DucTrung1802/ROS-2-Reports/Images/Drying - evaporating solvents from painted surfaces.jpg

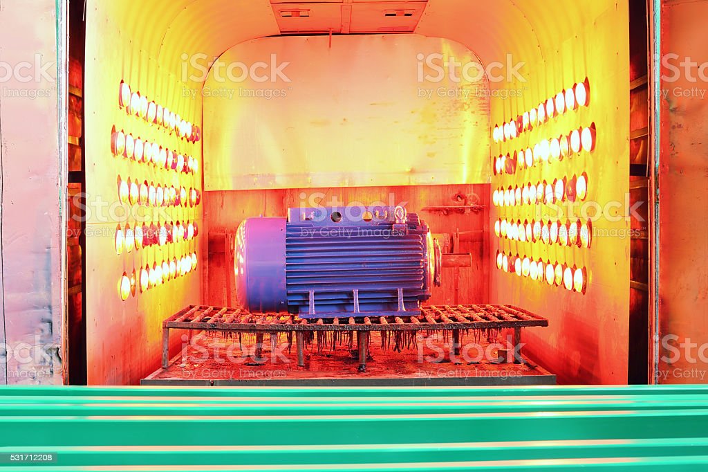
Images/Drying - evaporating solvents from painted surfaces.jpg
