DucTrung1802/ROS-2-Reports/Images/Heat treatment of metals.jpeg

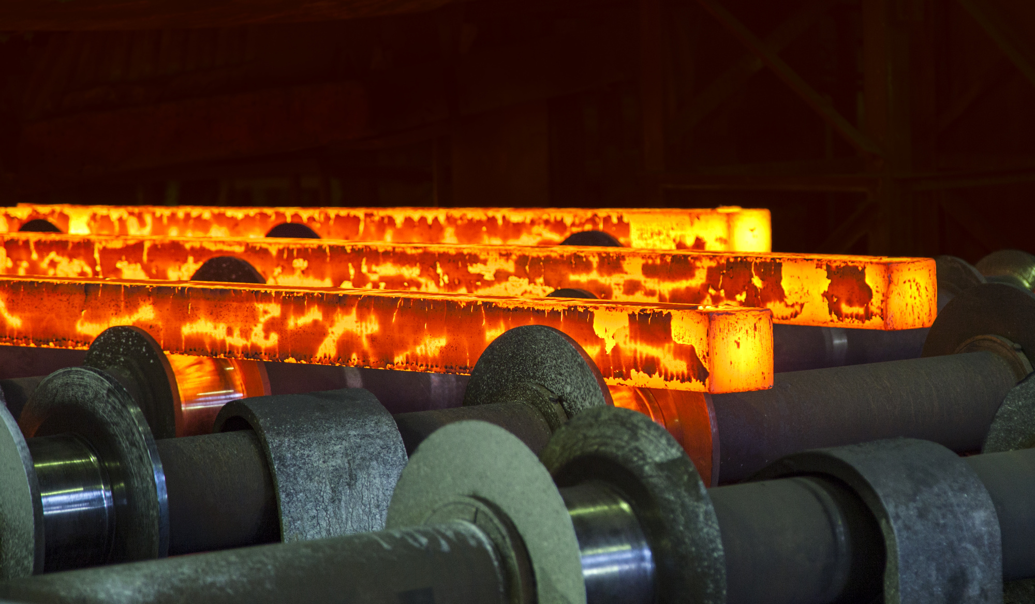
Images/Heat treatment of metals.jpeg
