DucTrung1802/ROS-2-Reports/Battery Status.docx

Battery | Mainboard | ADC | Monitor | Differience
12.58 | 12.27 | 3.072 | 3.072 | 0
12.48 | 12.20 | 3.055 | 3.044 | 0.011
12.46 | 12.19 | 3.053 | 3.039 | 0.014
12.43 | 12.13 | 3.039 | 3.022 | 0.017
12.41 | 12.14 | 3.042 | 3.020 | 0.022
12.36 | 12.09 | 3.03 | 3.003 | 0.027
12.31 | 12.04 | 3.016 | 2.979 | 0.037
12.30 | 12.00 | 3.003 | 2.96 | 0.043
12.24 | 11.96 | 2.997 | 2.945 | 0.052
12.19 | 11.91 | 2.983 | 2.924 | 0.059
12.18 | 11.91 | 2.983 | 2.923 | 0.060
12.13 | 11.86 | 2.97 | 2.902 | 0.068
12.12 | 11.82 | 2.961 | 2.89 | 0.071
12.10 | 11.80 | 2.956 | 2.879 | 0.077
12.08 | 11.78 | 2.951 | 2.872 | 0.079
12.05 | 11.75 | 2.944 | 2.858 | 0.086

calibration
