DucTrung1802/ROS-2-Reports/Mục lục ServingBot - Lý Đức Trung.docx

HA NOI UNIVERSITY OF SCIENCE AND TECHNOLOGY

BACHELOR THESIS PROJECT

Serving Mobile Robot Design

LY DUC TRUNG

trung.ld181930@sis.hust.edu.vn

Mentor: | Ph. D Le Minh Thuy
Department: | Instrumentation and industrial informatics
School: | Electrical Engineering

HA NOI, 01/2022

TABLE OF CONTENTS

TABLE OF CONTENTS

LIST OF FIGURES

LIST OF TABLES

# CHAPTER 1. GENERAL INTRODUCTION ABOUT MOBILE ROBOT

## 1.1 Overall information about mobile robot

## 1.2 Serving mobile robot design planning

# CHAPTER 2. GENERAL HARDWARE DESIGN FOR SERVING MOBILE ROBOT

## 2.1 Hardware components

### 2.1.1 Raspberry Pi 4

### 2.1.2 ESP32 microcontroller

### 2.1.3 Motors

### 2.1.4 Motor driver

### 2.1.5 Encoders

### 2.1.6 Ultrasonic sensors

### 2.1.7 Lidar

### 2.1.8 Inertial measurement unit

### 2.1.9 OLED display

### 2.1.10 Infrared sensor

### 2.1.11 Voltage sensor

## 2.2 Hardware structure design

# CHAPTER 3. ROS 2 FRAMEWORK FOR DEVELOPING ROBOTS

## 3.1 Robot software platforms

## 3.2 The basis for selecting ROS 2

## 3.3 The change of the ROS version

## 3.4 ROS 2 introduction

# CHAPTER 4. FIRMWARE DESIGN FOR SERVING MOBILE ROBOT

## 4.1 Raspberry Pi 4 configuration

### 4.1.1 Ubuntu version

### 4.1.2 zRAM

### 4.1.3 ROS 2 Galactic

### 4.1.4 Multiple I2C buses

## 4.2 Serving mobile robot firmware architecture

## 4.3 Firmware for motor driver block

### 4.3.1 Firmware for ESP32 microcontroller

## 4.4 Firmware for ultrasonic sensors

## 4.5 Firmware for lidar

## 4.6 Firmware for inertial measurement unit

## 4.7 Firmware for OLED display

## 4.8 Firmware for infrared sensor

## 4.9 Firmware for voltage sensor

# CHAPTER 5. ALGORITHM EXPLANATION FOR FIRMWARE

## 5.1 PID controller

## 5.2 Fuzzy logic library

## 5.3 Kinematic Model for calculating Odometry data

## 5.4 Kalman filter

## 5.5 Median filter

# CHAPTER 6. OPTIMIZATION

## 6.1 Object oriented programming

## 6.2 Multithreading programming

# CHAPTER 7. EXPERIMENT AND RESULTS

## 7.1 Comparison of PID controller and Fuzzy PID controller

## 7.2 Obstacle avoidance using an array of ultrasonic sensors test cases

## 7.3 Restaurant serving test cases

## 7.4 Serving mobile robot design result

CONCLUSION AND FUTURE DEVELOPMENT

REFERENCES
