DucTrung1802/ROS-2-Reports/Images/121 Remote IO error.png

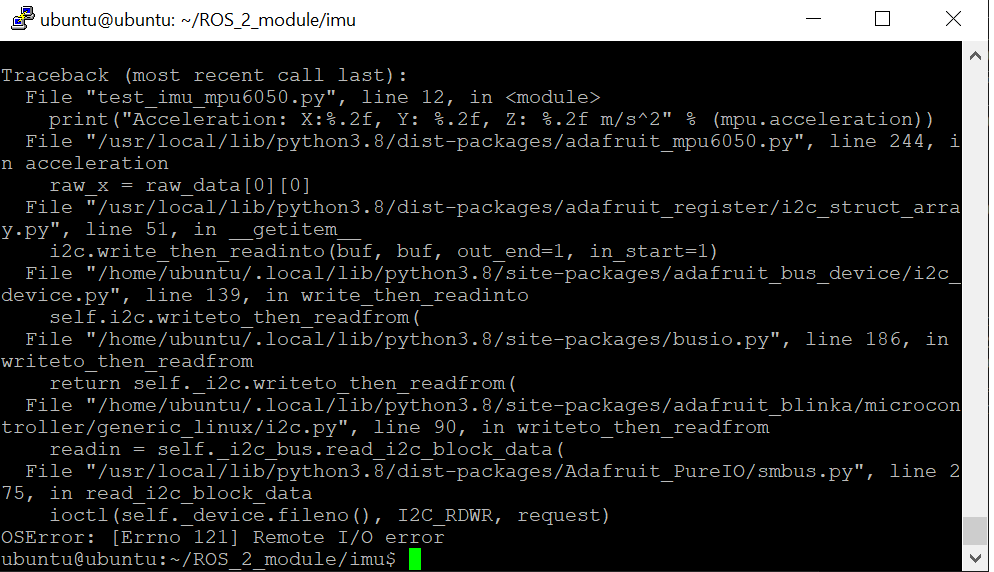
Images/121 Remote IO error.png
