DucTrung1802/ROS-2-Reports/Images/A sample camera message.png

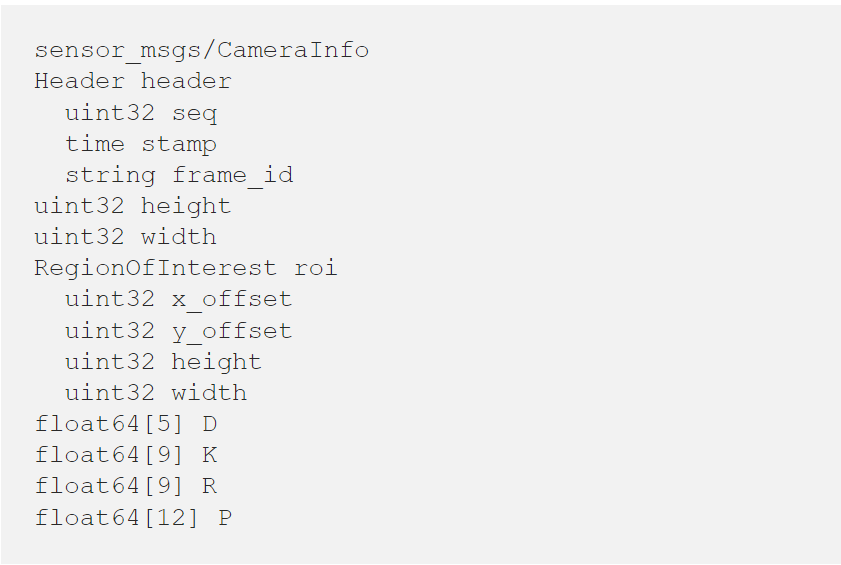
Images/A sample camera message.png
