DucTrung1802/ROS-2-Reports/Images/addRule method of Mamdani Fuzzy System class.png

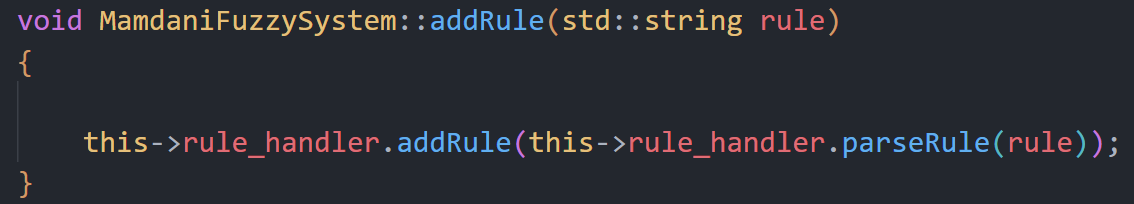
Images/addRule method of Mamdani Fuzzy System class.png
