DucTrung1802/ROS-2-Reports/Images/anti-windup flowchart.png

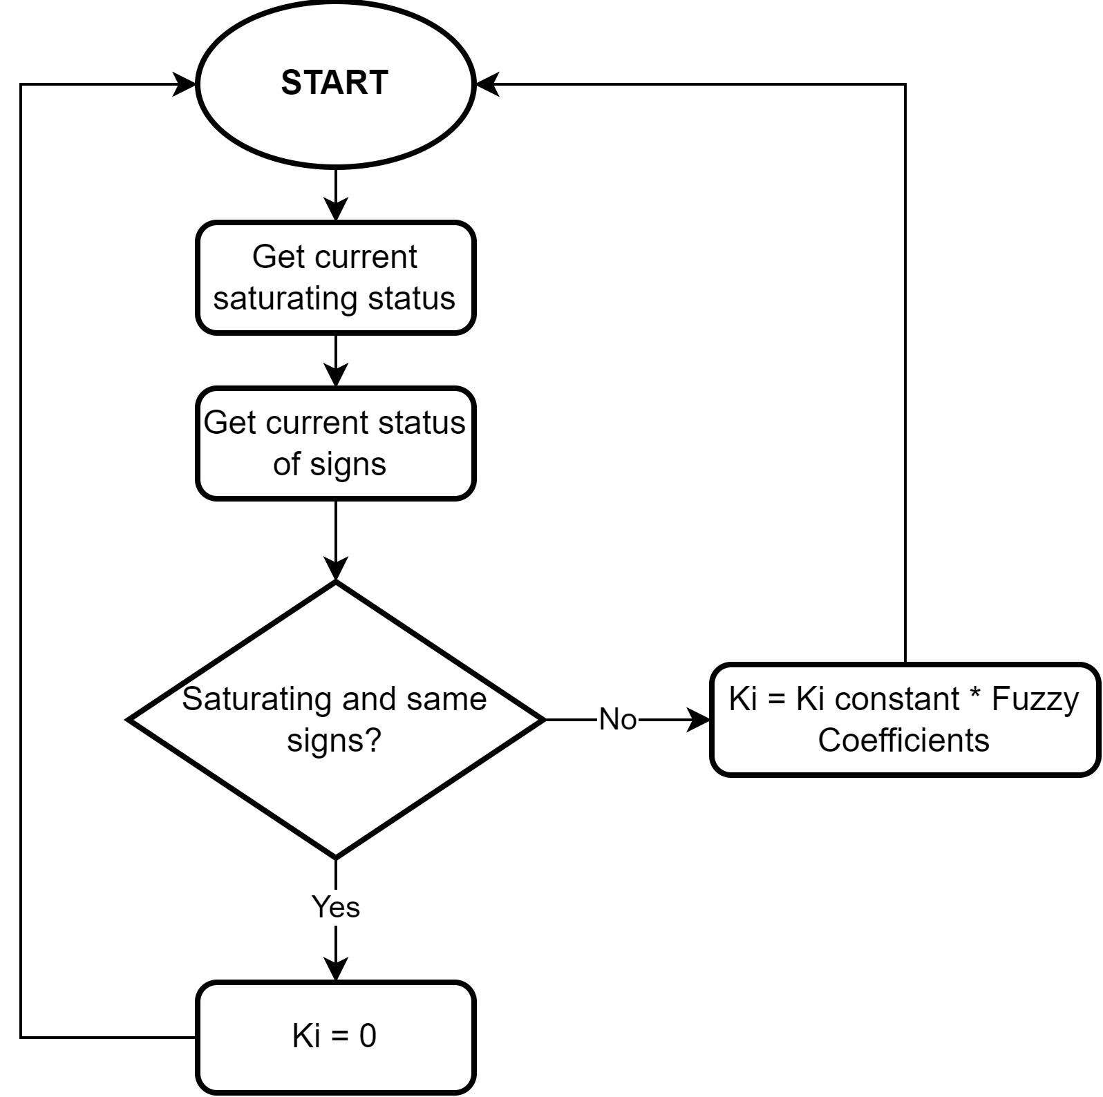
Images/anti-windup flowchart.png
