DucTrung1802/ROS-2-Reports/Images/Baking.jpg

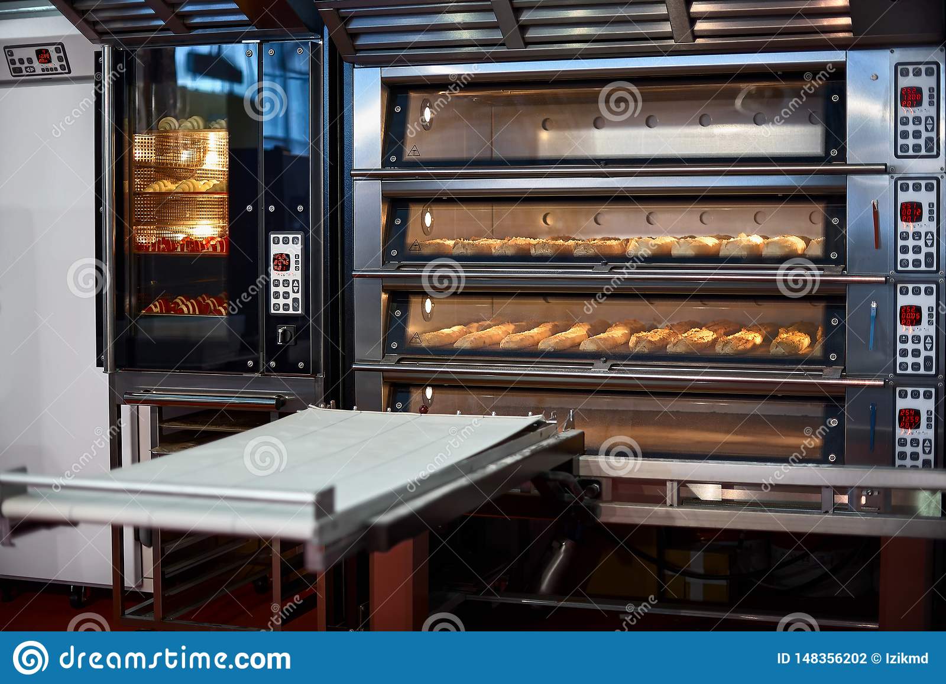
Images/Baking.jpg
