DucTrung1802/ROS-2-Reports/Images/Baking.webp

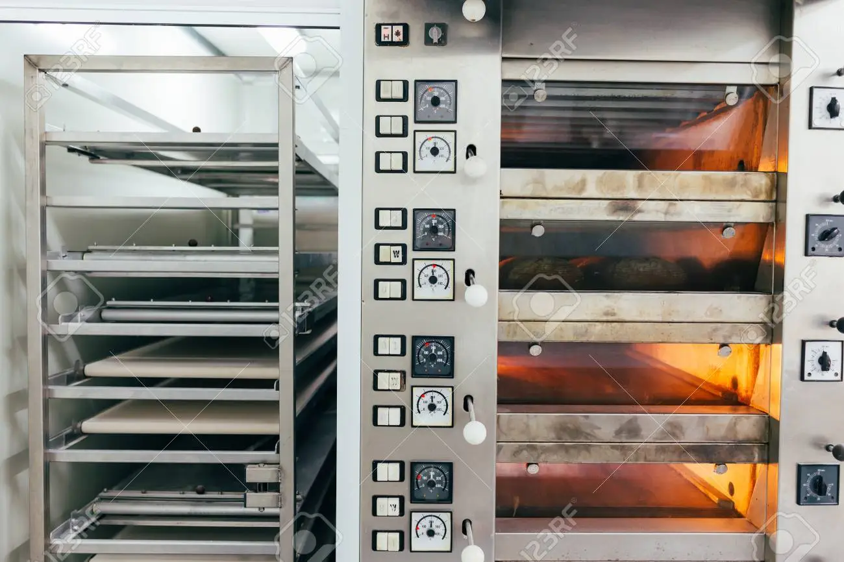
Images/Baking.webp
