DucTrung1802/ROS-2-Reports/Images/Binary AND vs Fuzzy AND.png

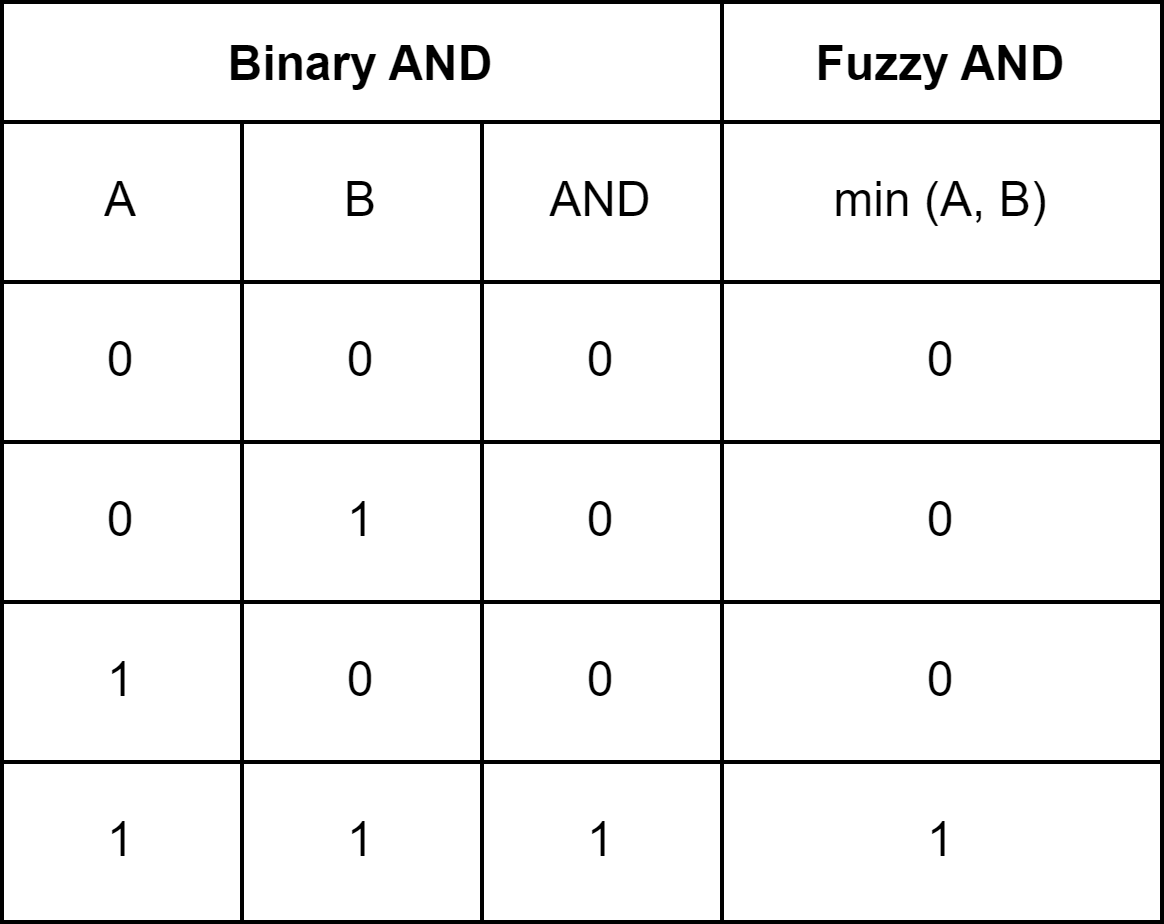
Images/Binary AND vs Fuzzy AND.png
