DucTrung1802/ROS-2-Reports/Images/C++ files compilation.png

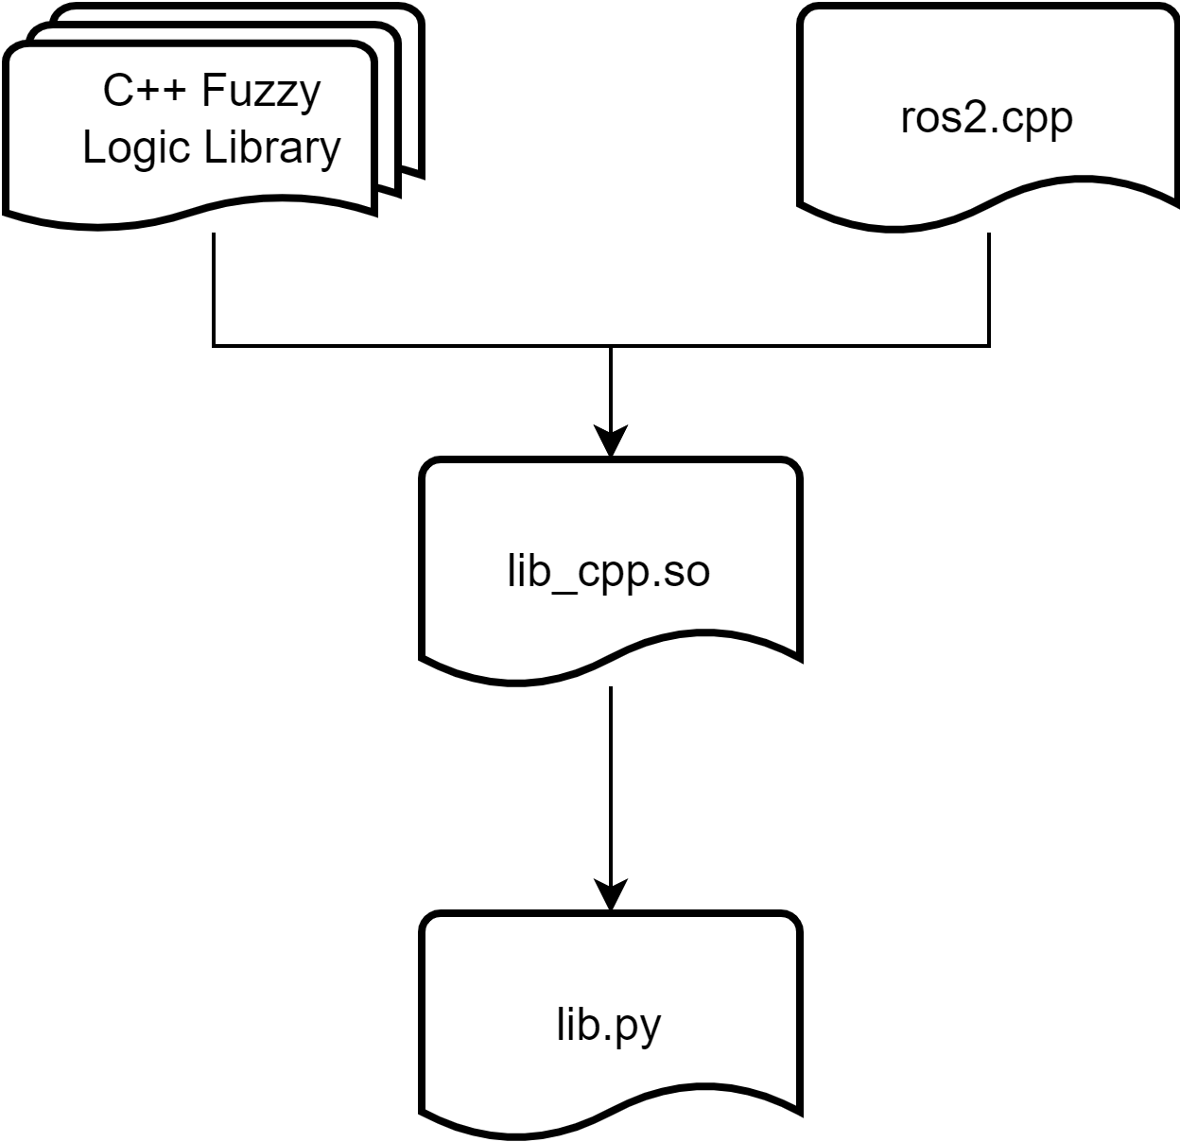
Images/C++ files compilation.png
