DucTrung1802/ROS-2-Reports/Images/C++ Fuzzy Logic Library.png

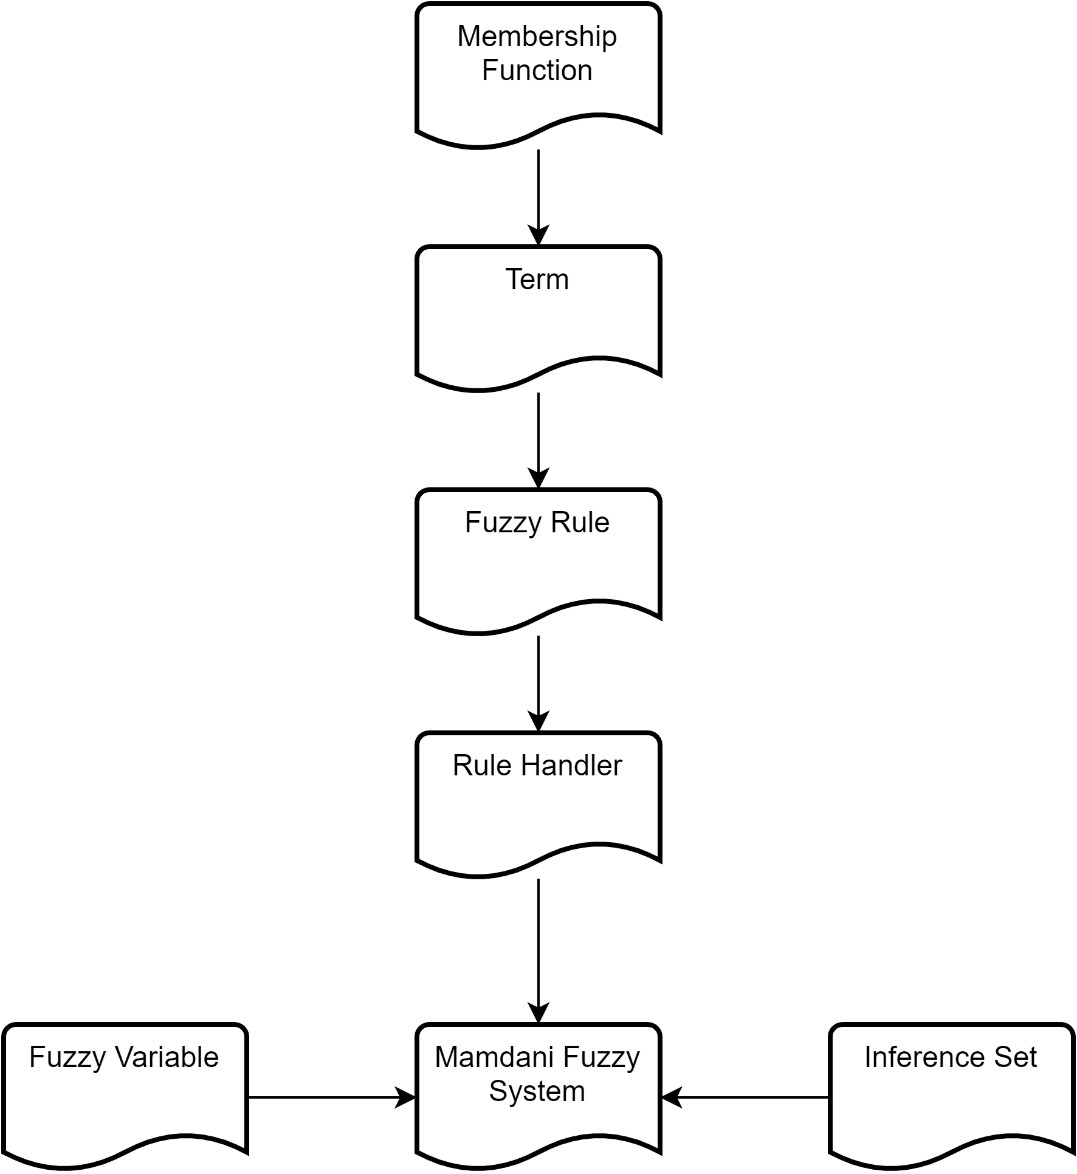
Images/C++ Fuzzy Logic Library.png
