DucTrung1802/ROS-2-Reports/Images/calculate method of Mamdani Fuzzy System.png

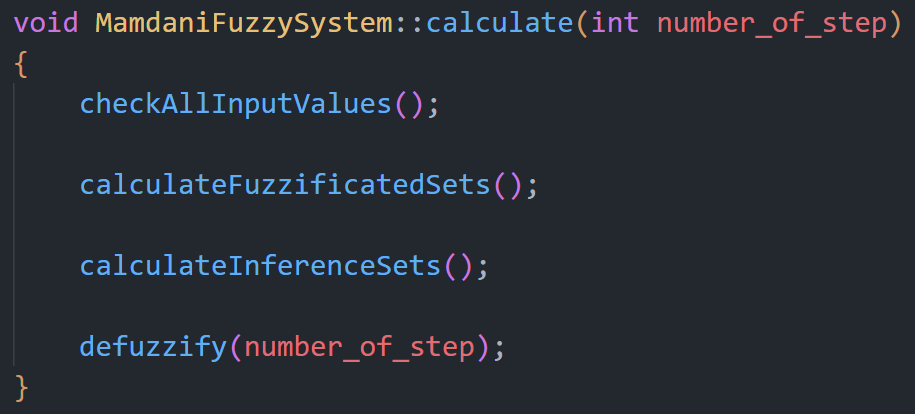
Images/calculate method of Mamdani Fuzzy System.png
