DucTrung1802/ROS-2-Reports/Images/Calling C++ code from Python.png

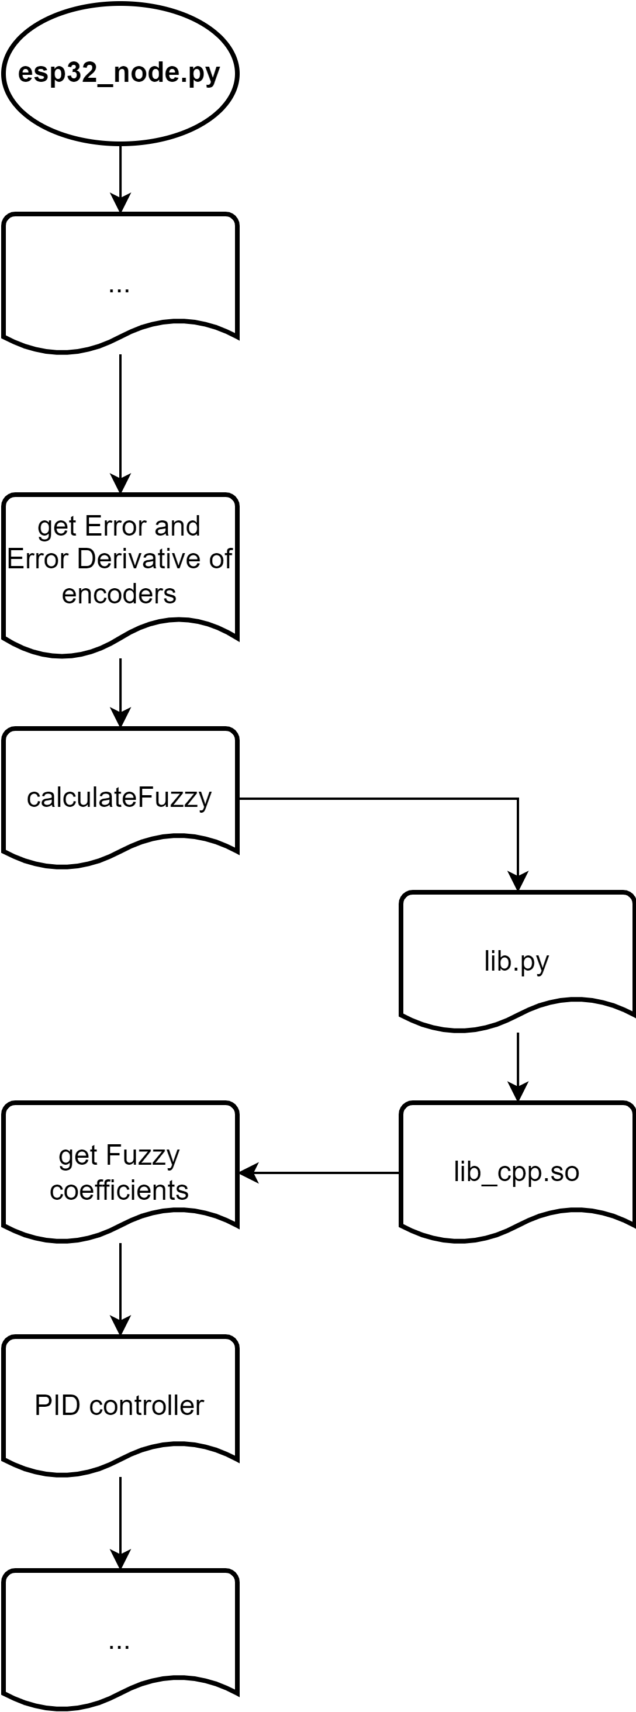
Images/Calling C++ code from Python.png
