DucTrung1802/ROS-2-Reports/Images/Centroid of combined shape.png

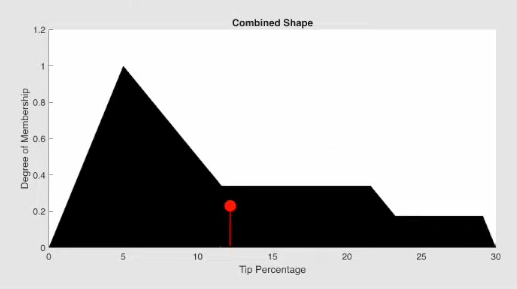
Images/Centroid of combined shape.png
