DucTrung1802/ROS-2-Reports/Images/Combined Shape of Inference Set.png

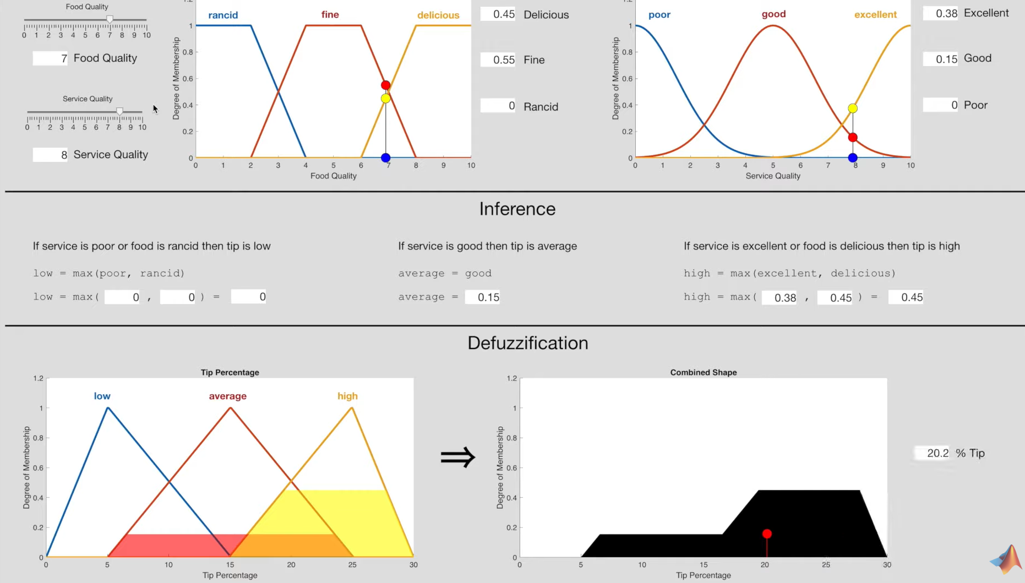
Images/Combined Shape of Inference Set.png
