DucTrung1802/ROS-2-Reports/Images/Composition of the RViz screen.png

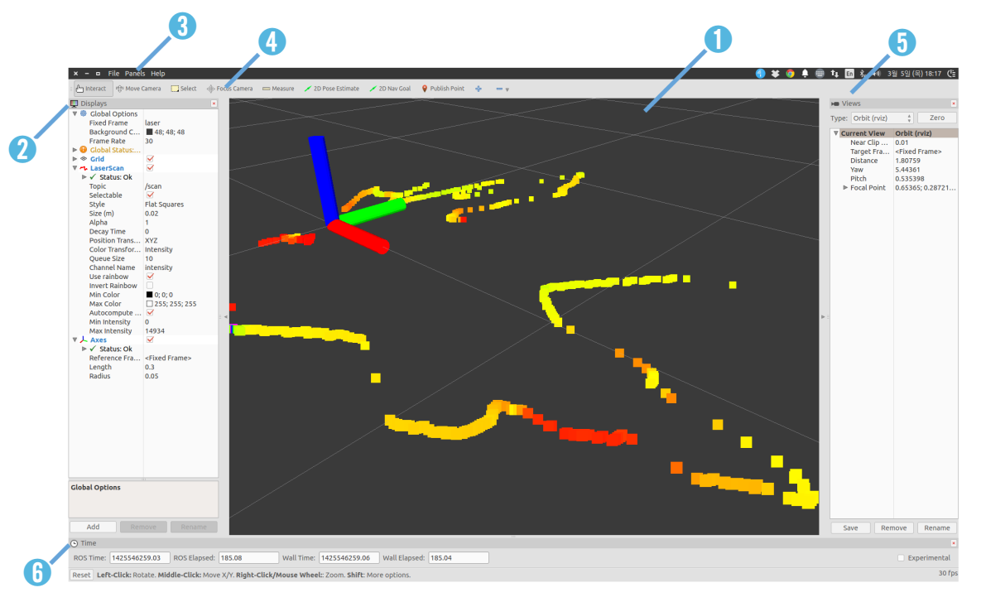
Images/Composition of the RViz screen.png
