DucTrung1802/ROS-2-Reports/Images/Curing rubber.jpg

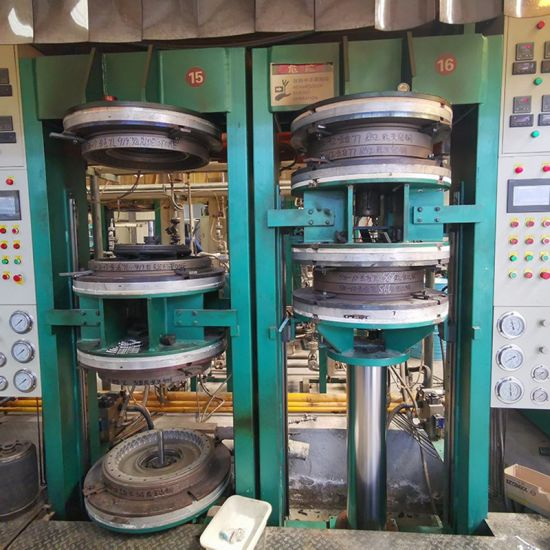
Images/Curing rubber.jpg
