DucTrung1802/ROS-2-Reports/Images/dtoverlay in bashrc.png

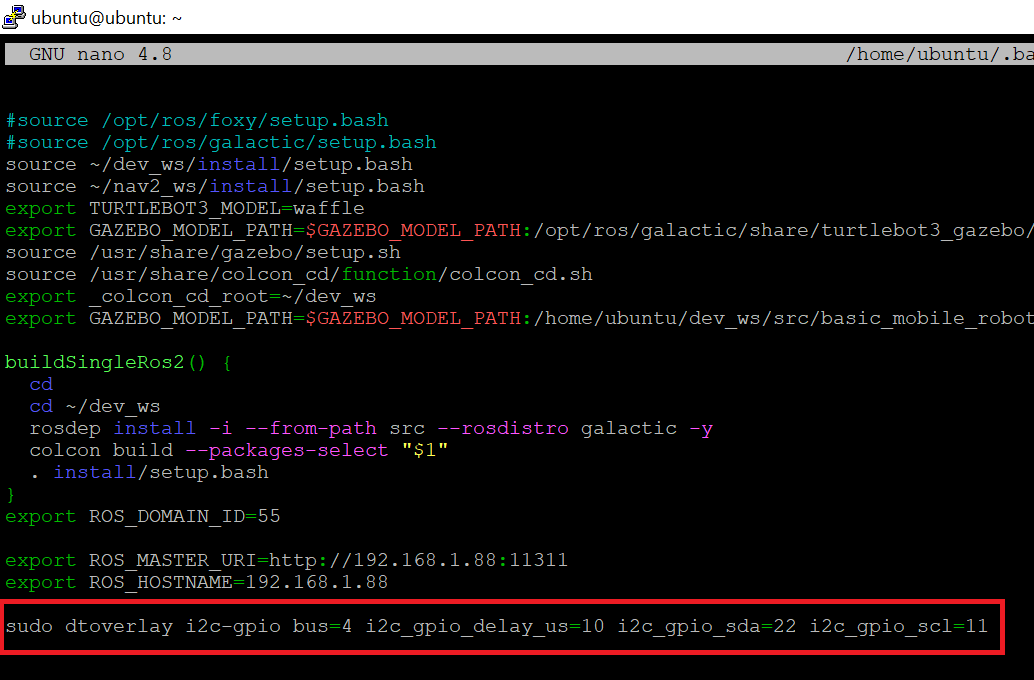
Images/dtoverlay in bashrc.png
