DucTrung1802/ROS-2-Reports/Images/Example of Fuzzificated Set.png

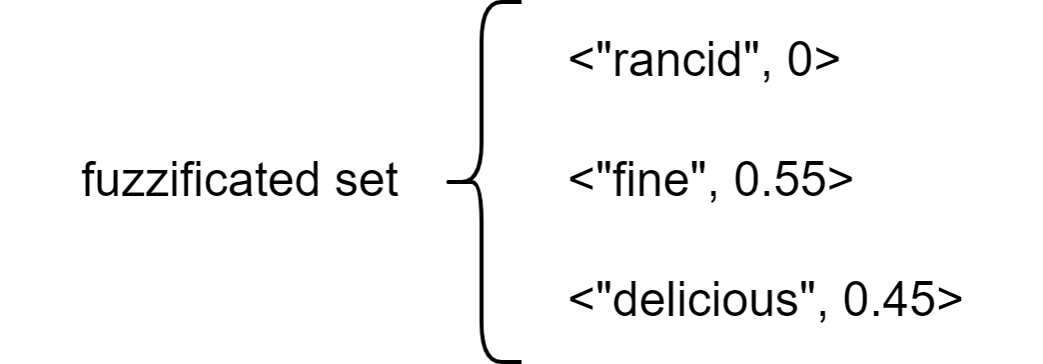
Images/Example of Fuzzificated Set.png
