DucTrung1802/ROS-2-Reports/Images/Example of Inference Set.png

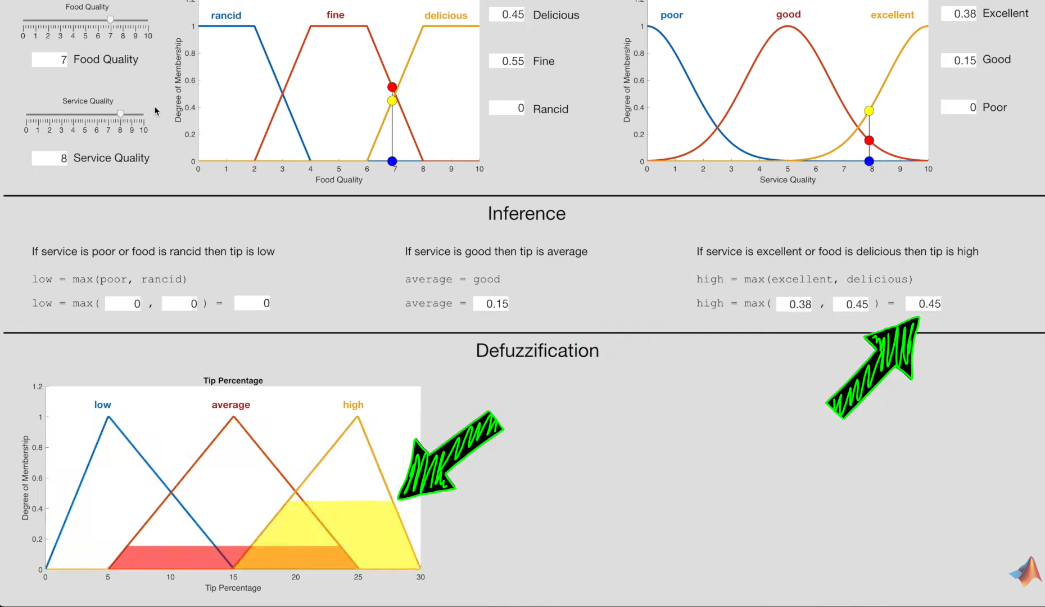
Images/Example of Inference Set.png
