DucTrung1802/ROS-2-Reports/Images/Example of list_of_term.png

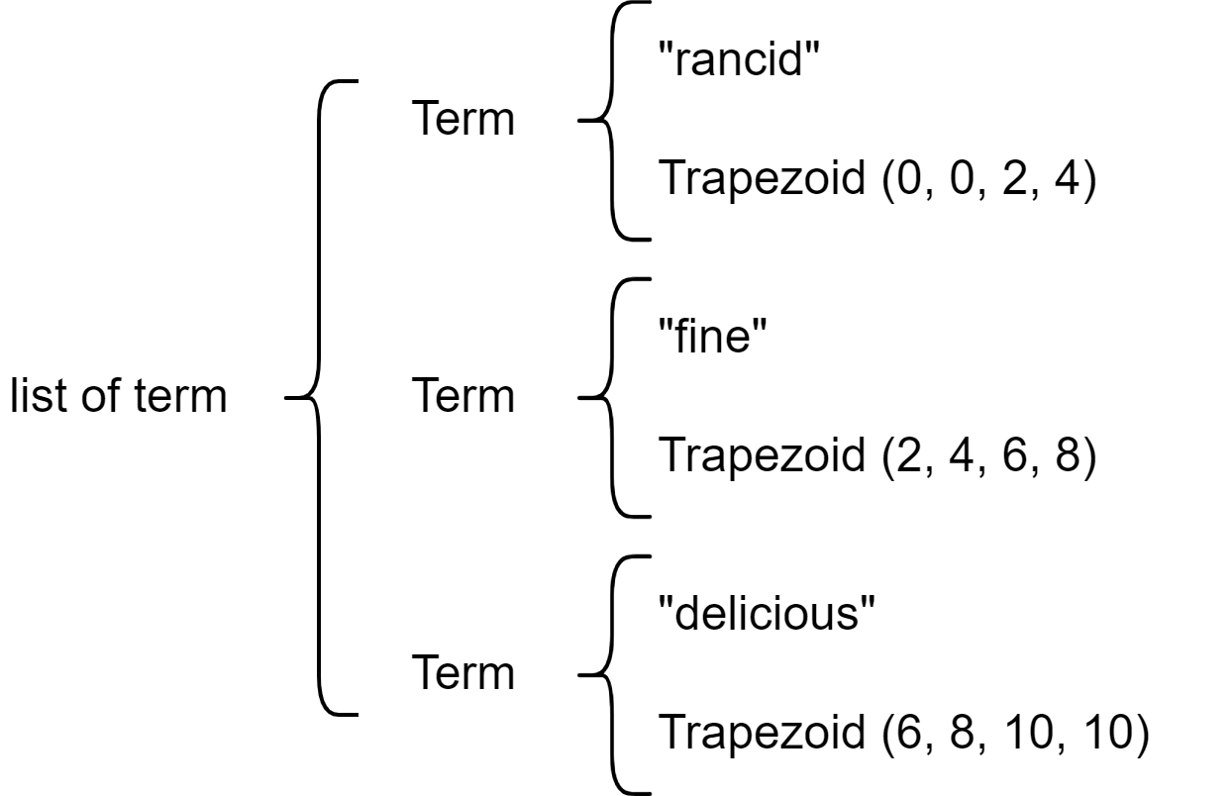
Images/Example of list_of_term.png
