DucTrung1802/ROS-2-Reports/Images/filter bandwith of IMU MPU-6050.png

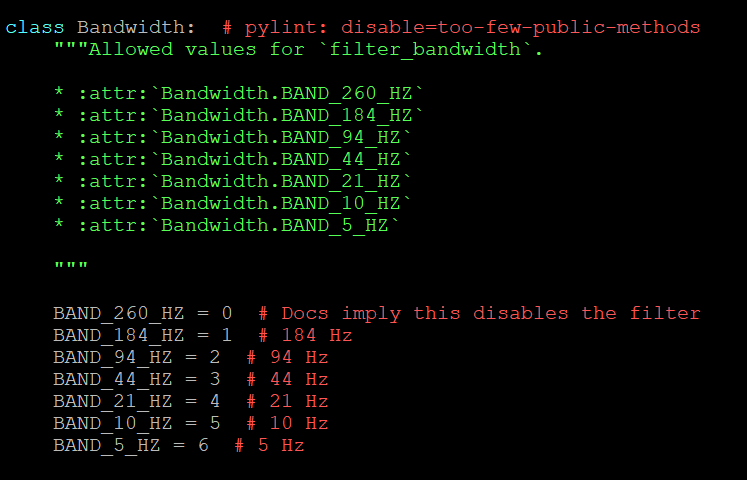
Images/filter bandwith of IMU MPU-6050.png
