DucTrung1802/ROS-2-Reports/Images/Flowchart of Raspberry Pi 4 for infrared sensor node.png

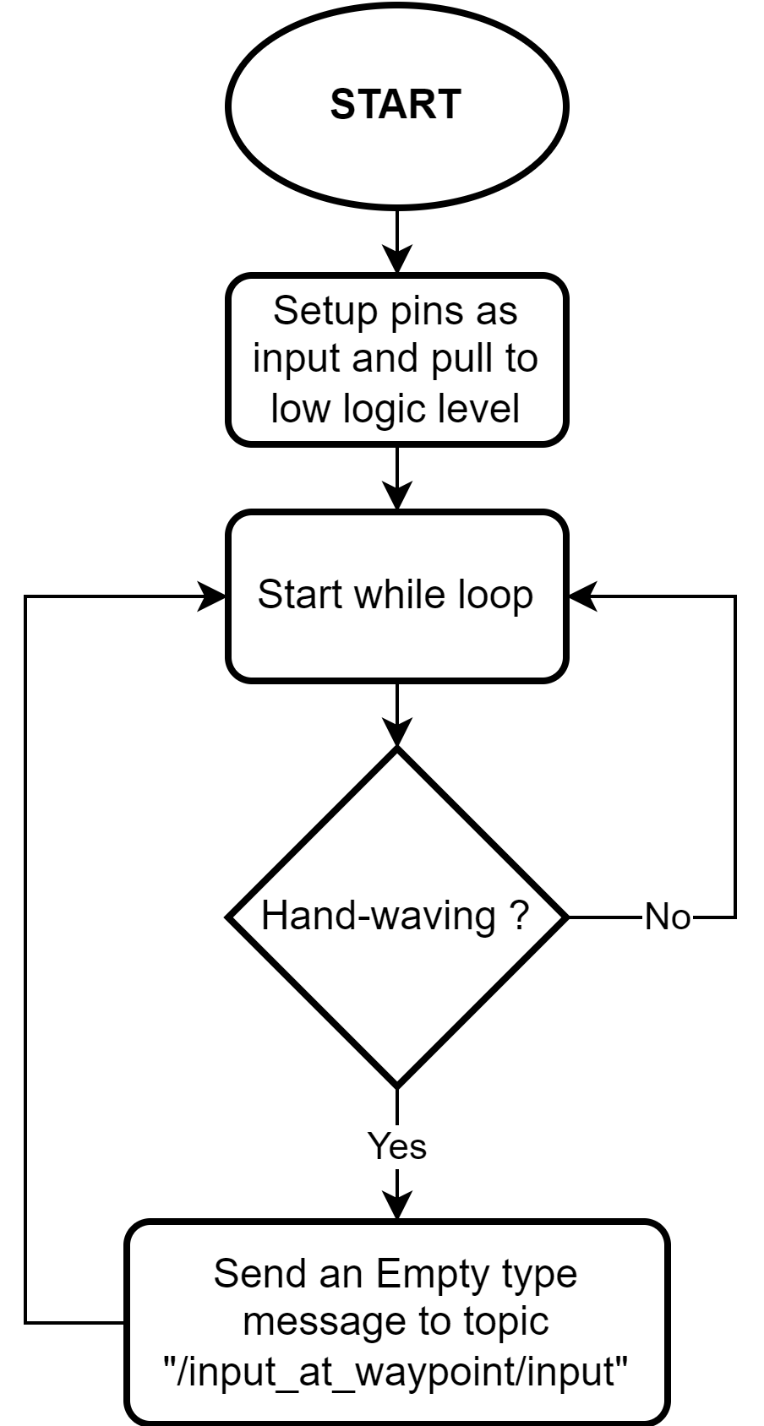
Images/Flowchart of Raspberry Pi 4 for infrared sensor node.png
