DucTrung1802/ROS-2-Reports/Images/Fuzzy PID controller flowchart.png

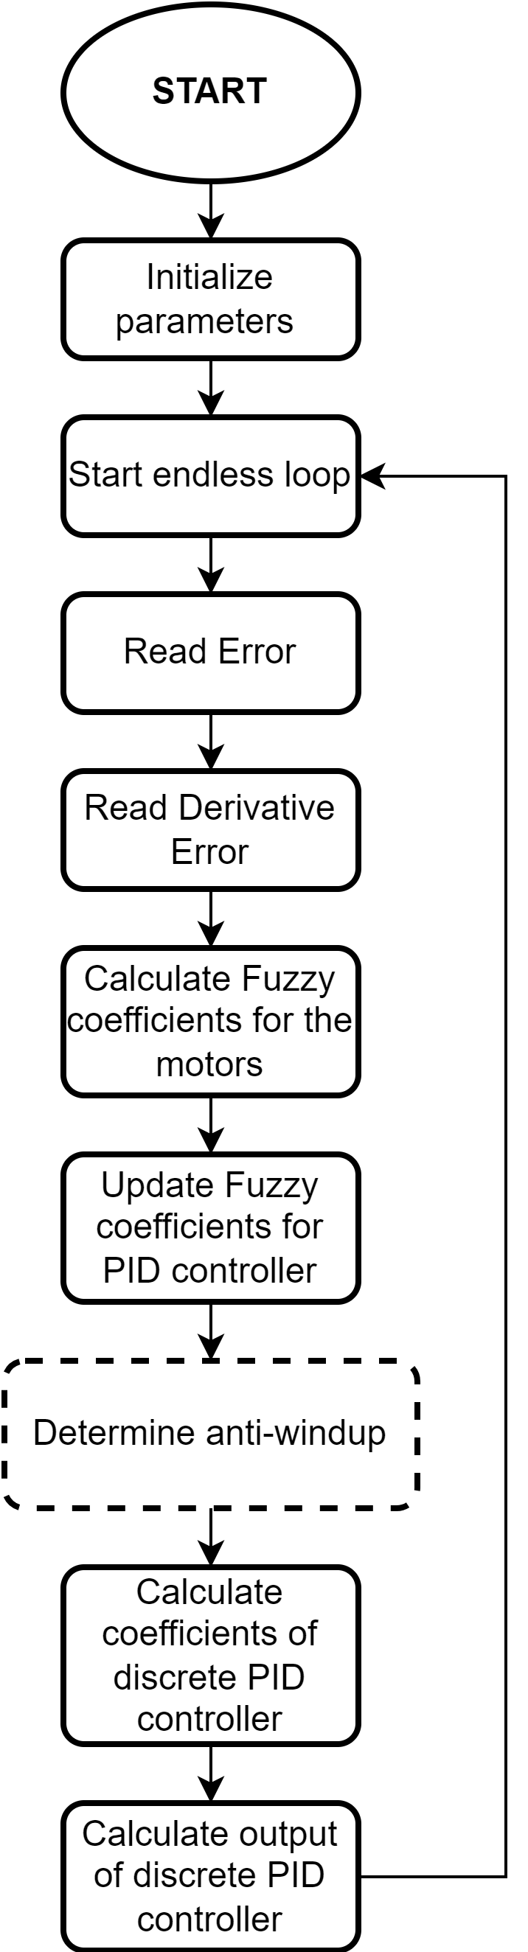
Images/Fuzzy PID controller flowchart.png
