DucTrung1802/ROS-2-Reports/Images/Fuzzy Rule class.png

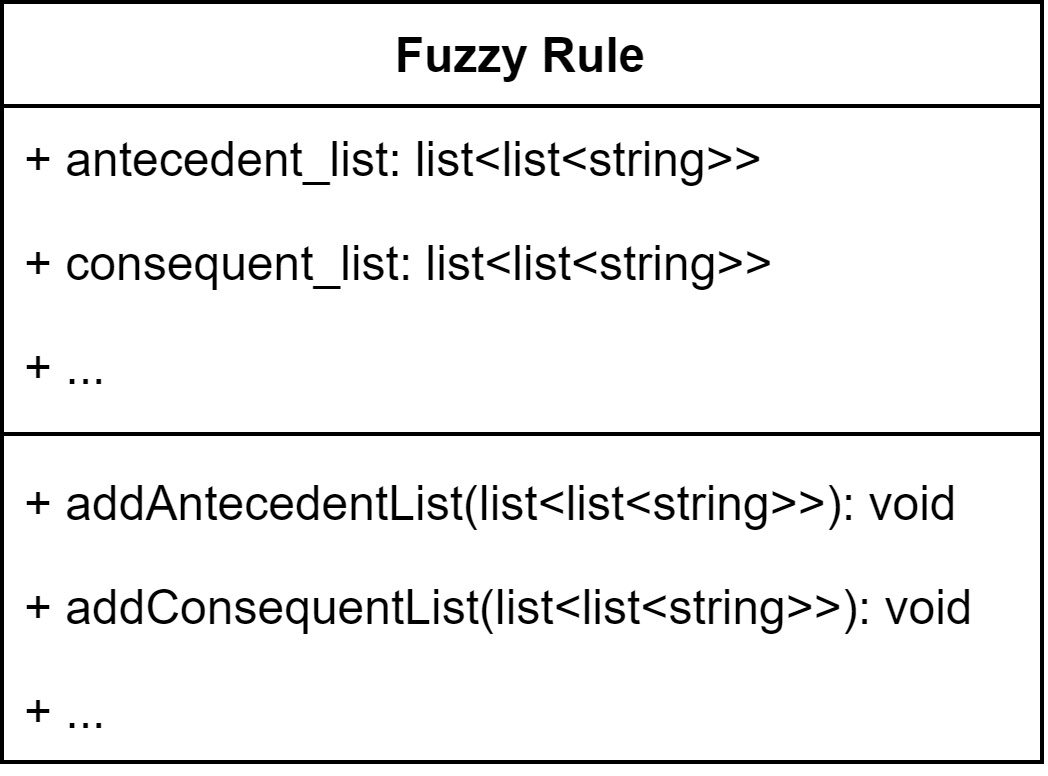
Images/Fuzzy Rule class.png
