DucTrung1802/ROS-2-Reports/Images/Fuzzy Rule Example.png

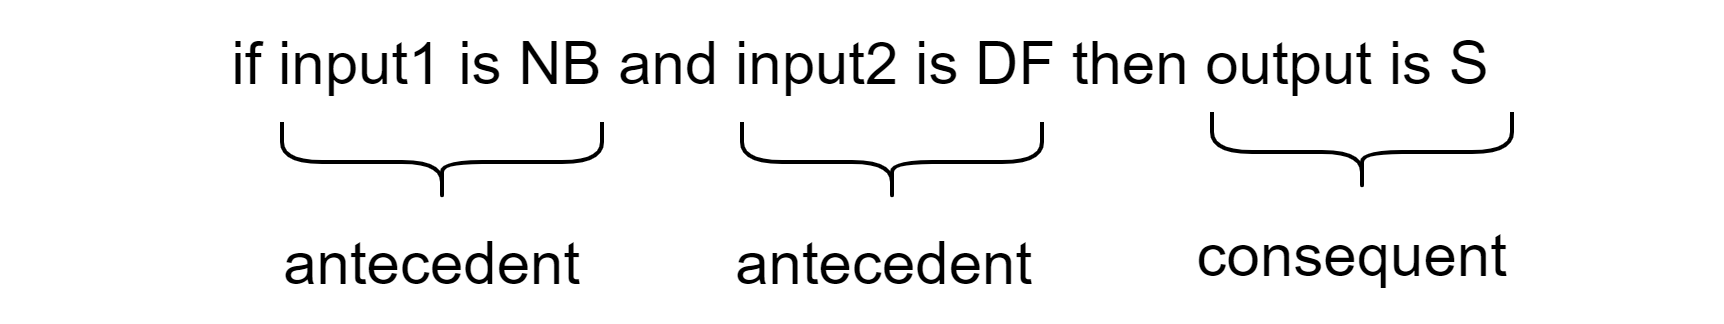
Images/Fuzzy Rule Example.png
