DucTrung1802/ROS-2-Reports/Images/Fuzzy Variable class.png

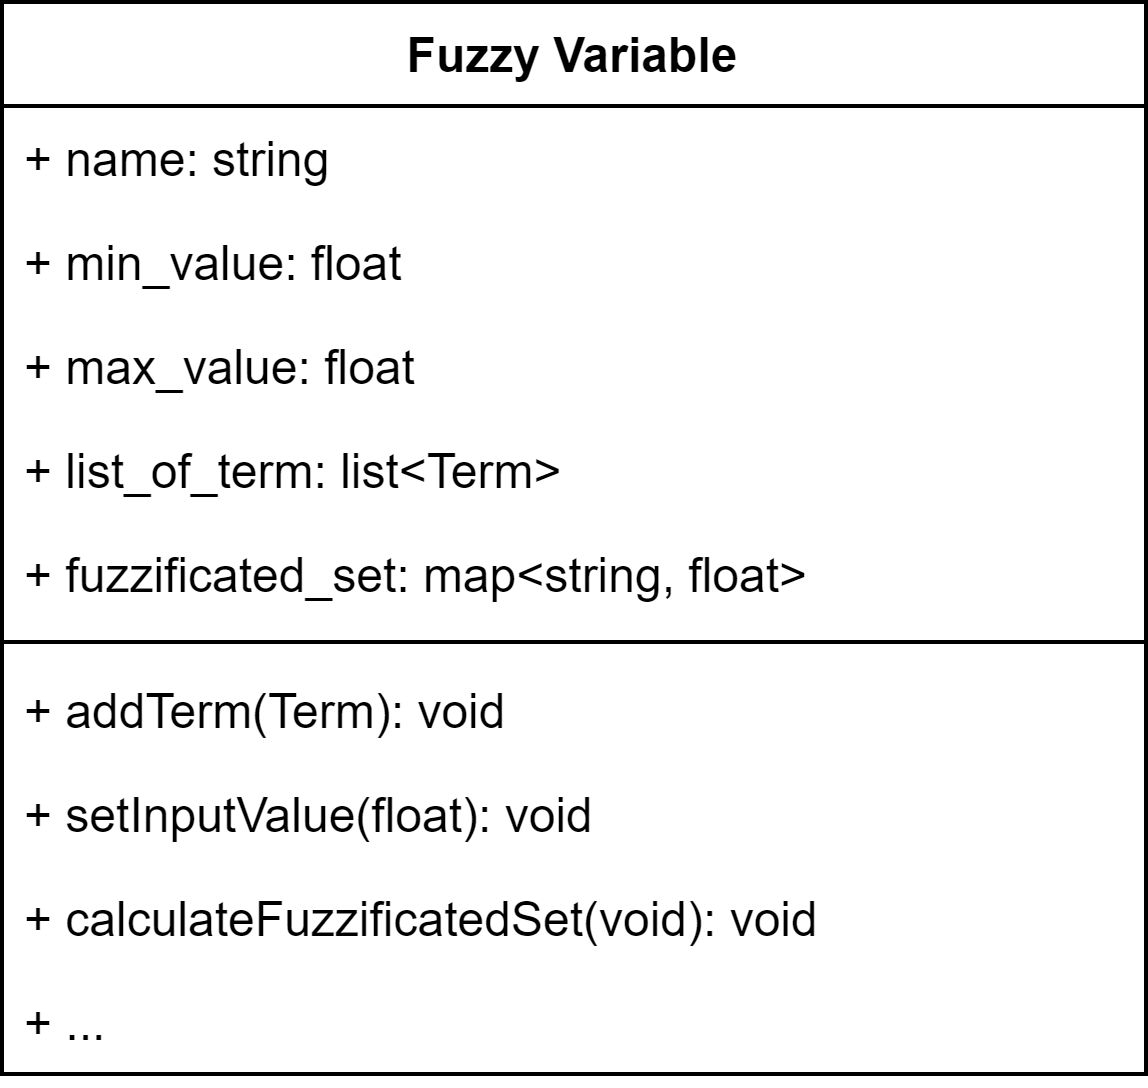
Images/Fuzzy Variable class.png
