DucTrung1802/ROS-2-Reports/Images/IMU runs normally.png

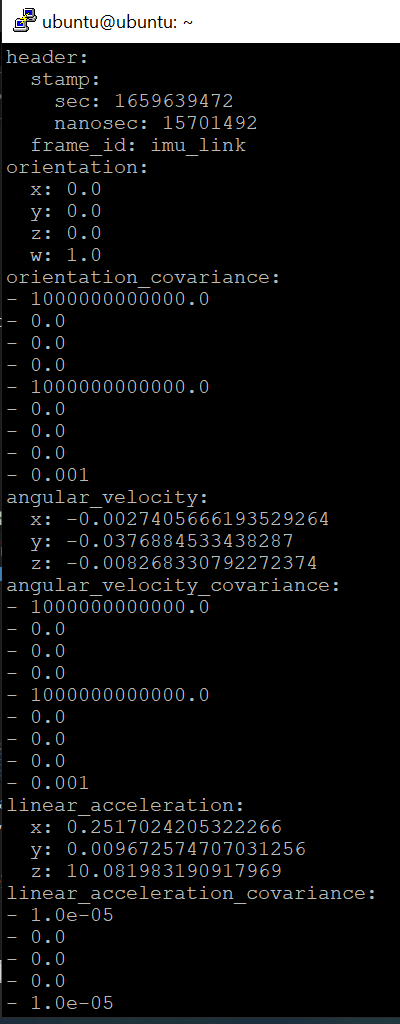
Images/IMU runs normally.png
