DucTrung1802/ROS-2-Reports/Images/Inference Set class.png

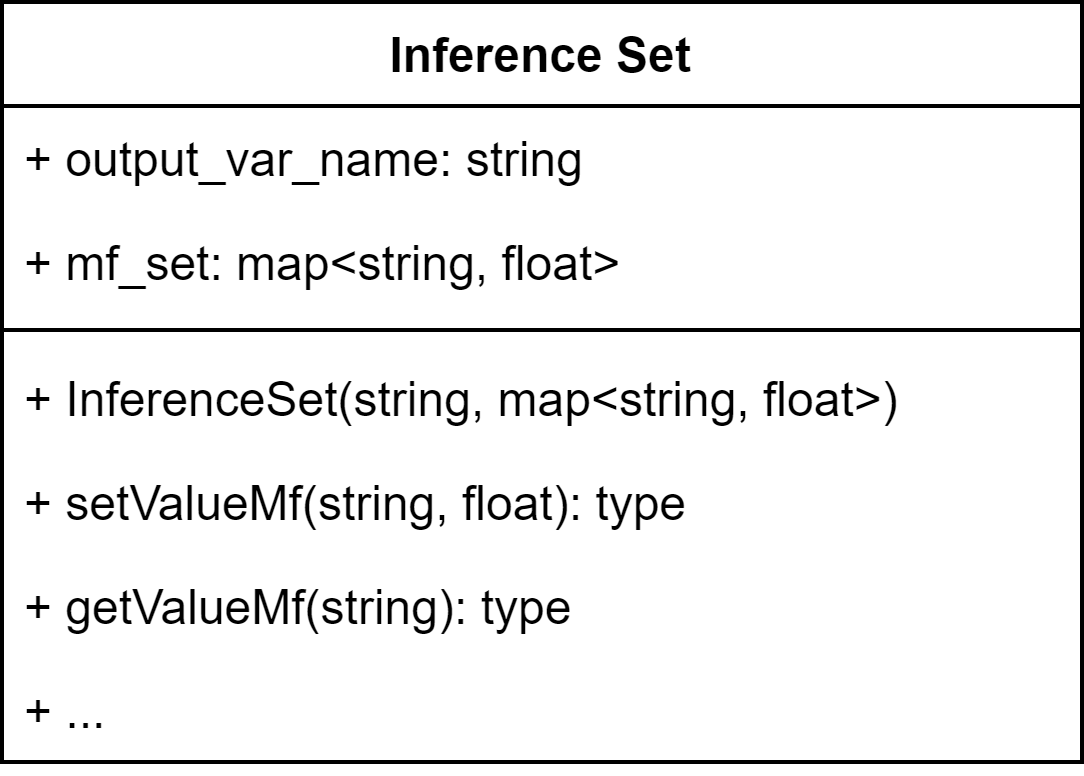
Images/Inference Set class.png
