DucTrung1802/ROS-2-Reports/Images/Infrared sensor block.png

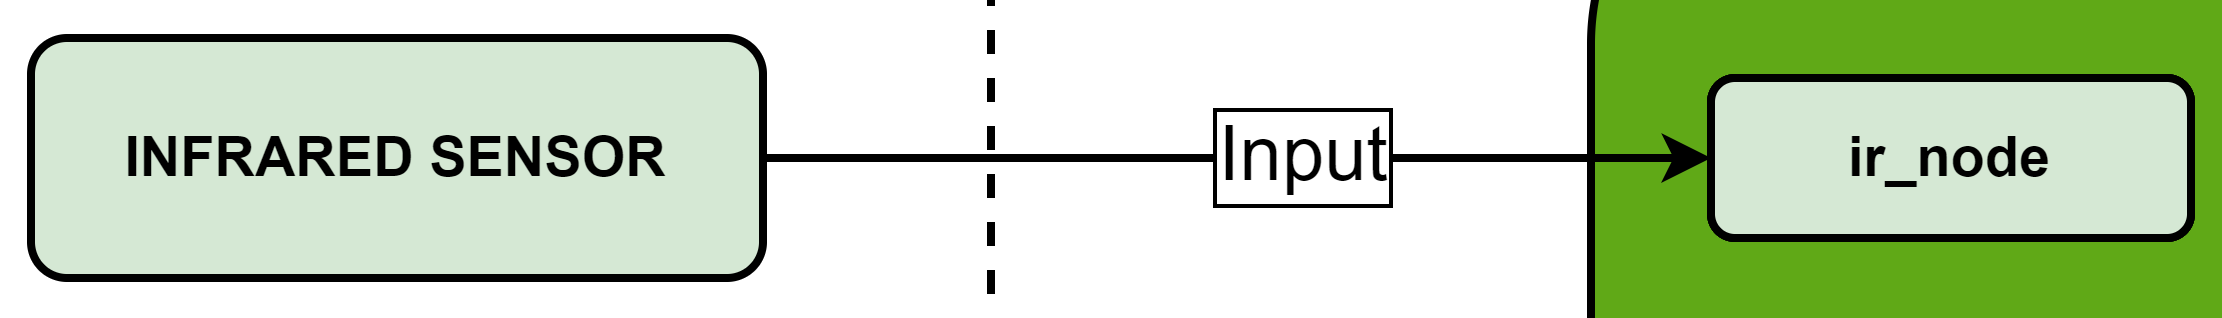
Images/Infrared sensor block.png
