DucTrung1802/ROS-2-Reports/Images/Initializing input variables of Fuzzy system.png

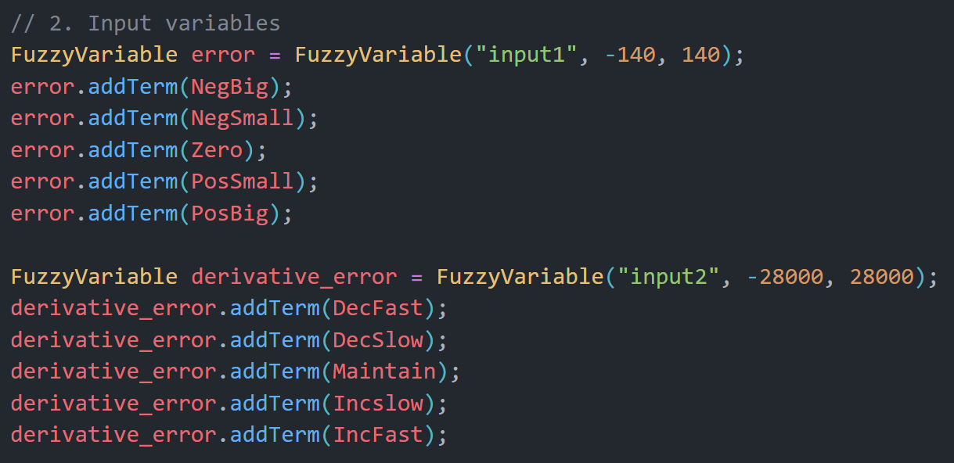
Images/Initializing input variables of Fuzzy system.png
