DucTrung1802/ROS-2-Reports/Images/Initializing output variables of Fuzzy system.png

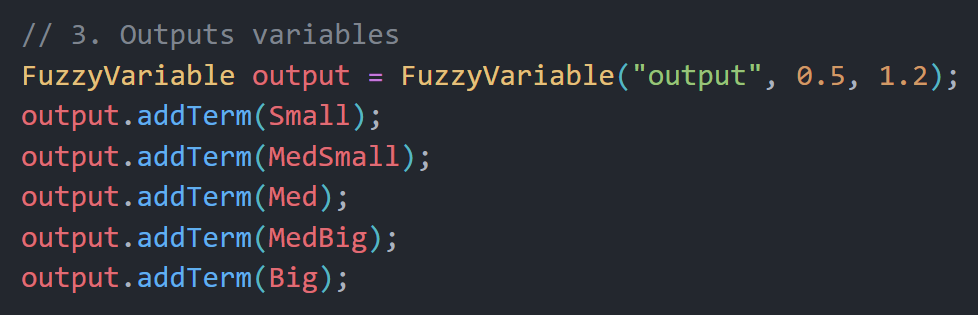
Images/Initializing output variables of Fuzzy system.png
