DucTrung1802/ROS-2-Reports/Images/Initializing rules of Fuzzy system.png

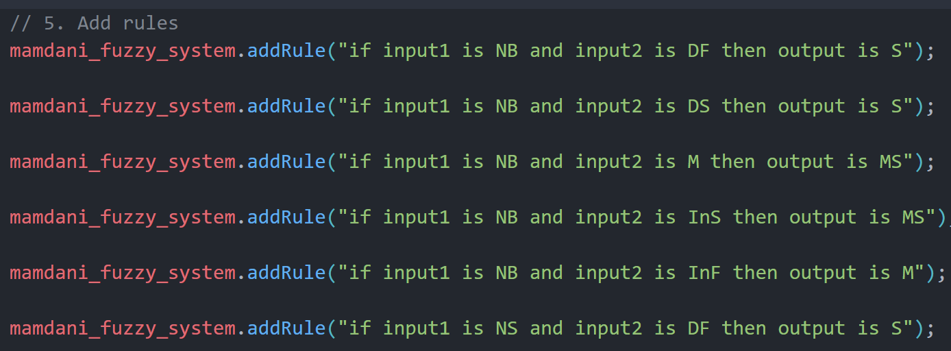
Images/Initializing rules of Fuzzy system.png
