DucTrung1802/ROS-2-Reports/Images/Initializing terms for derivative error of Fuzzy system.png

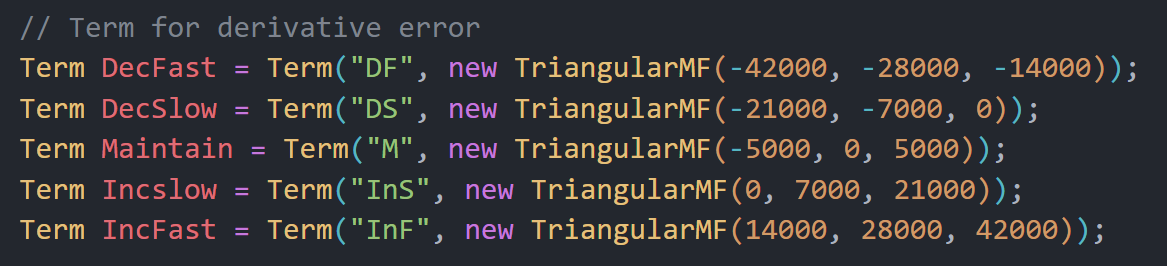
Images/Initializing terms for derivative error of Fuzzy system.png
