DucTrung1802/ROS-2-Reports/Images/Integral vs Sum.png

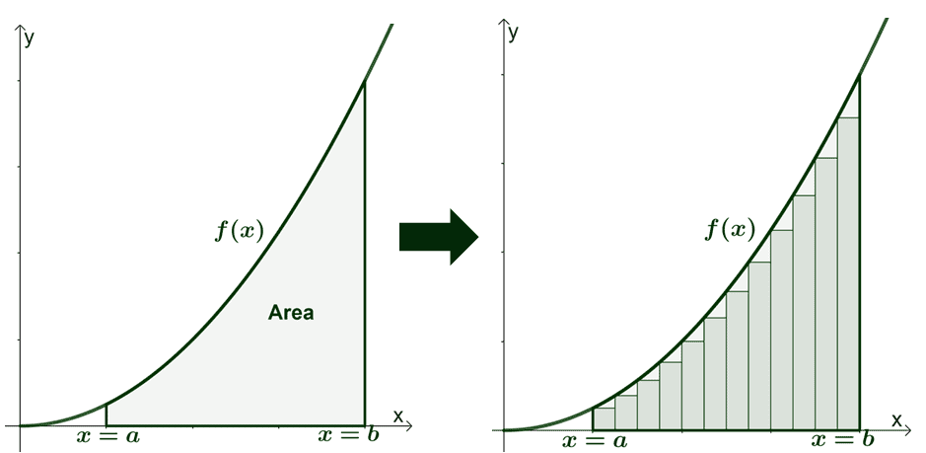
Images/Integral vs Sum.png
