DucTrung1802/ROS-2-Reports/Images/Lidar map.png

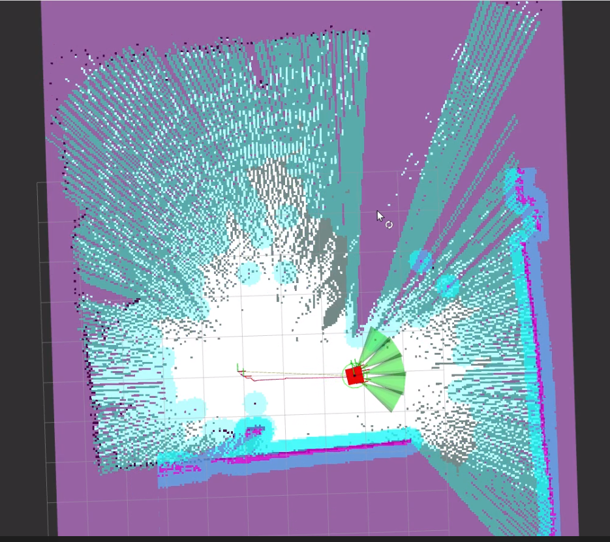
Images/Lidar map.png
