DucTrung1802/ROS-2-Reports/Images/Lidar sensor block.png

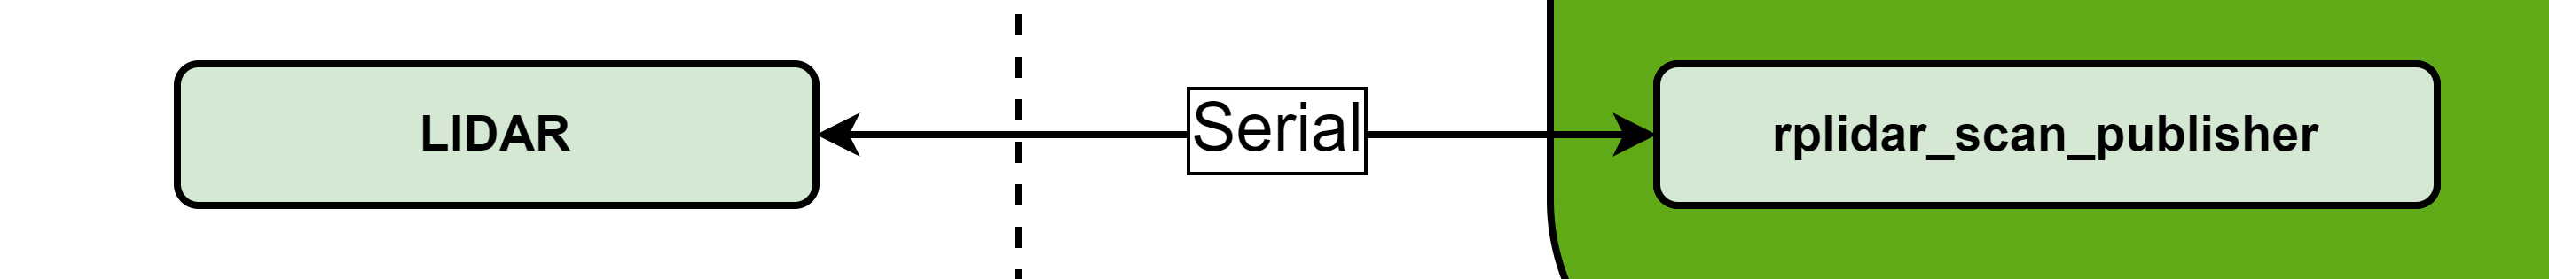
Images/Lidar sensor block.png
