DucTrung1802/ROS-2-Reports/Images/Loading screen of RViz.png

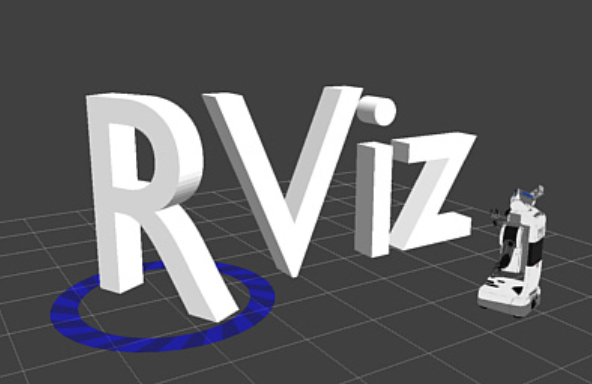
Images/Loading screen of RViz.png
