DucTrung1802/ROS-2-Reports/Images/Mamdani Fuzzy System class.png

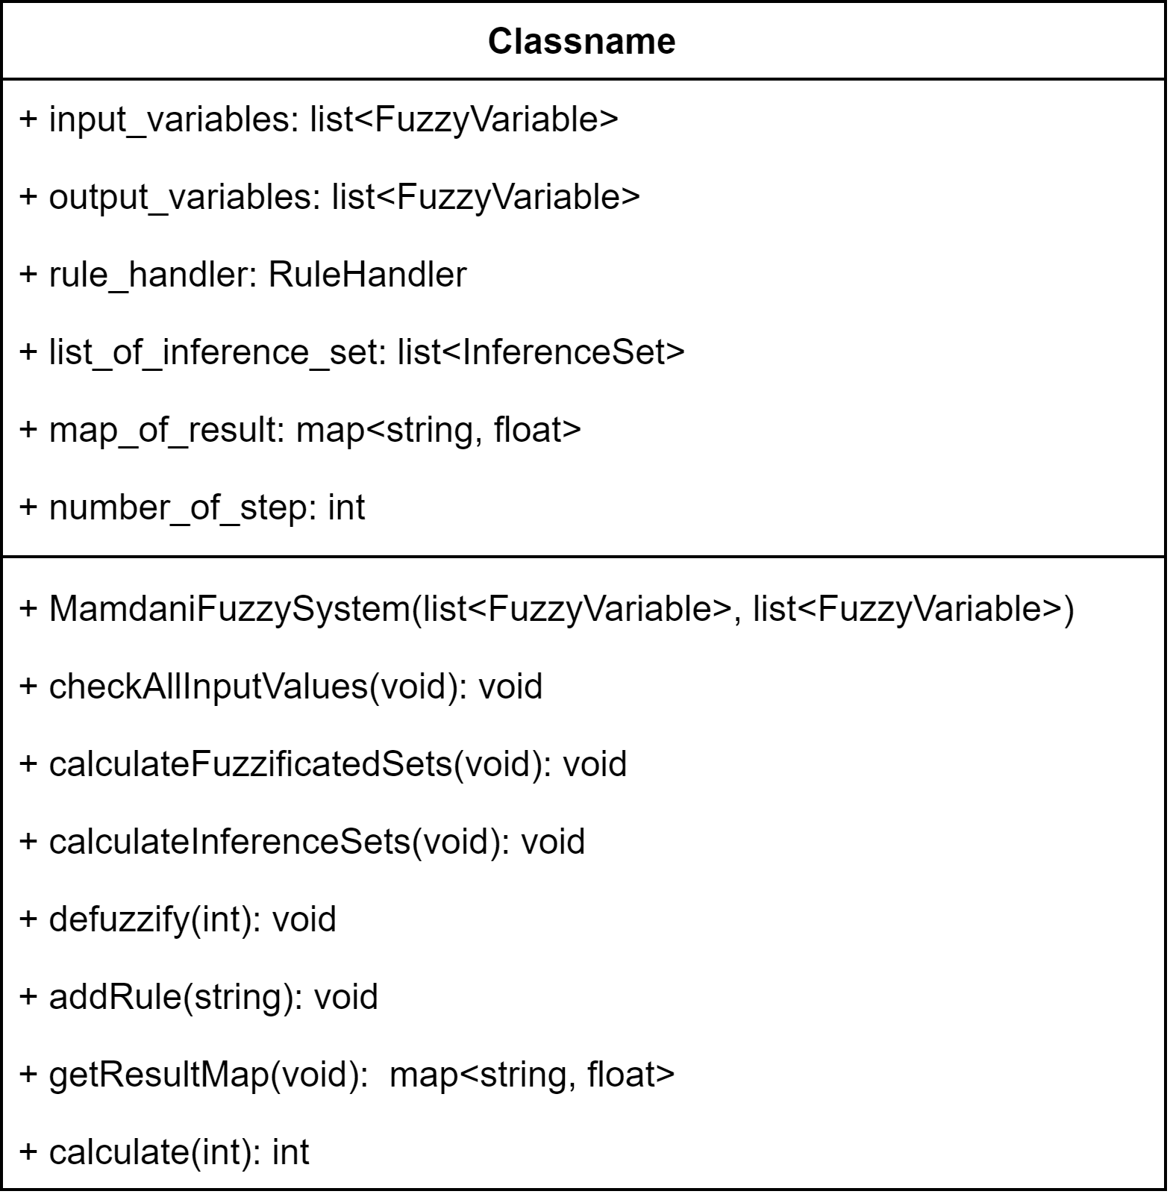
Images/Mamdani Fuzzy System class.png
