DucTrung1802/ROS-2-Reports/Images/Membership Function class.png

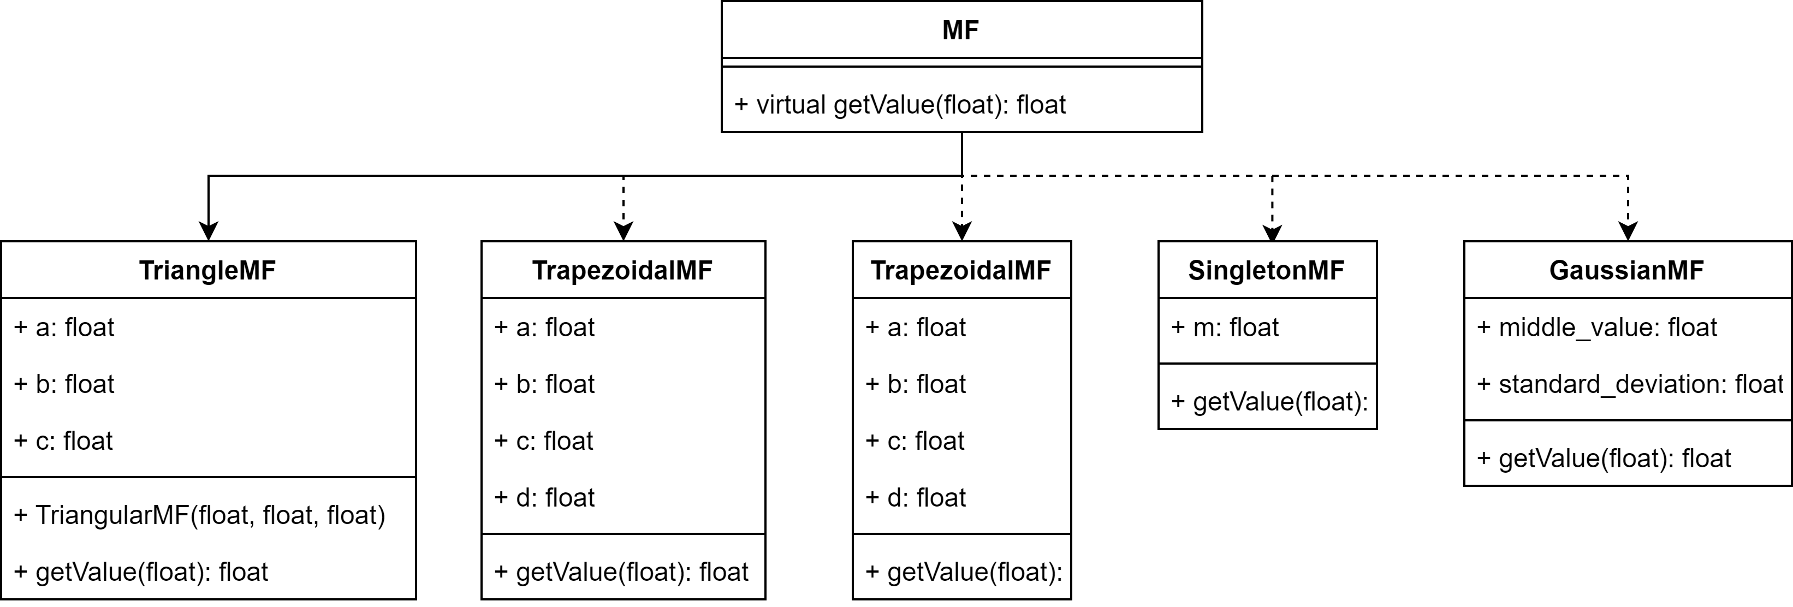
Images/Membership Function class.png
