DucTrung1802/ROS-2-Reports/Images/Motor driver block.png

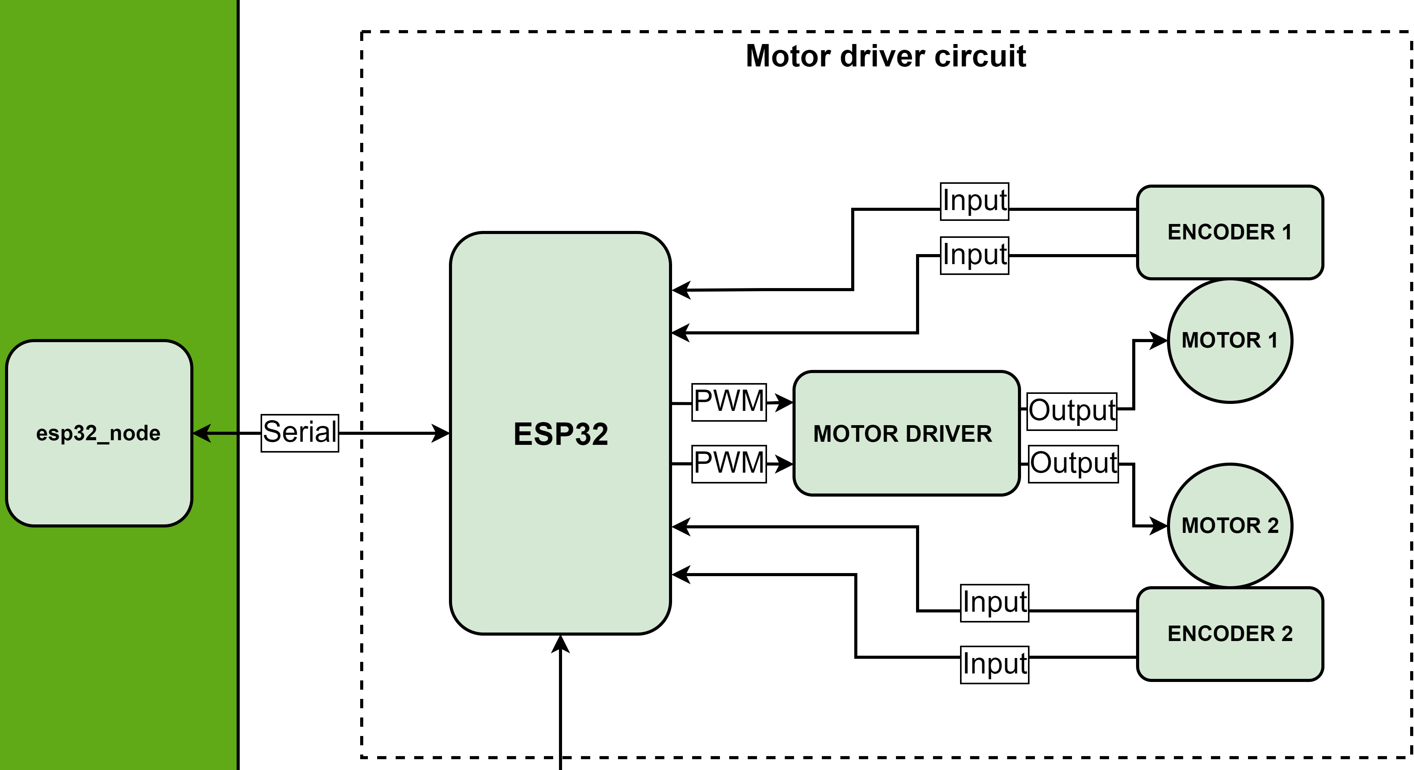
Images/Motor driver block.png
