DucTrung1802/ROS-2-Reports/Images/OLED display block.png

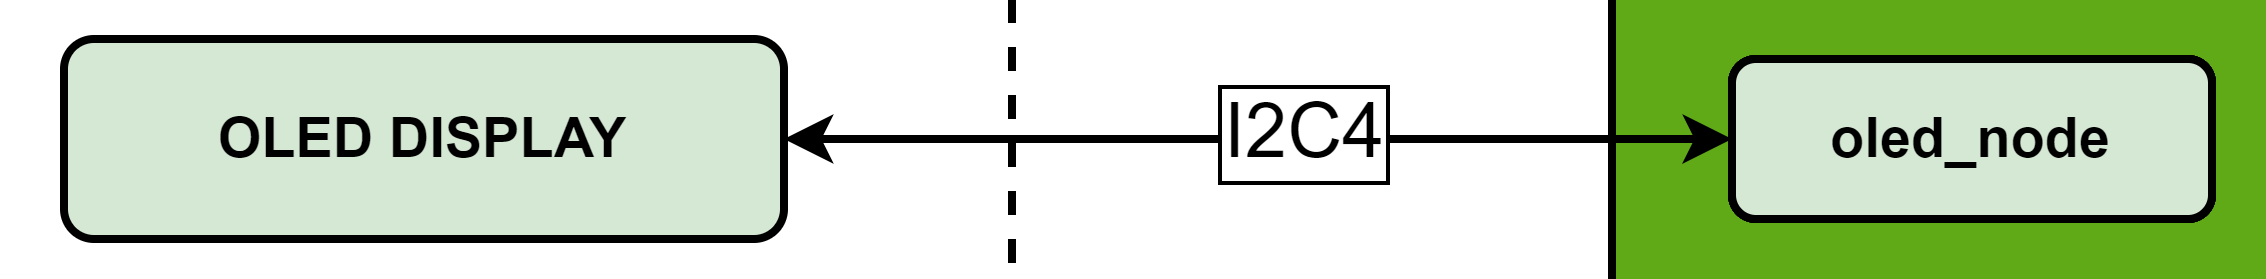
Images/OLED display block.png
