DucTrung1802/ROS-2-Reports/Images/OLED GOAL PROGRESS.png

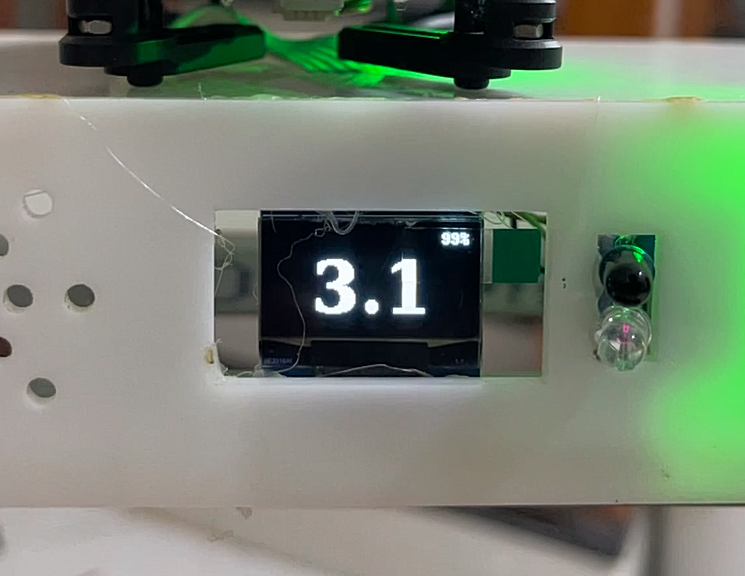
Images/OLED GOAL PROGRESS.png
