DucTrung1802/ROS-2-Reports/Images/OLED STARTING.png

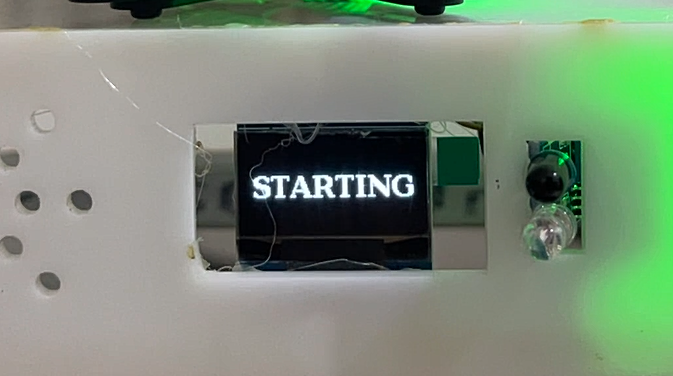
Images/OLED STARTING.png
