DucTrung1802/ROS-2-Reports/Images/OLED WAITING.jpg

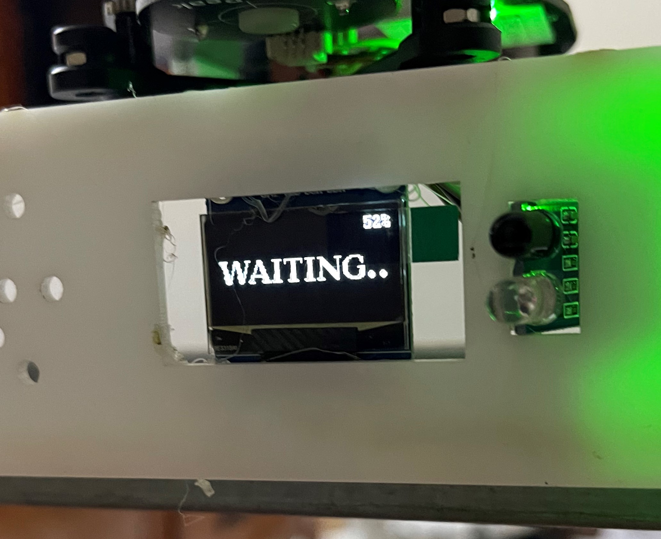
Images/OLED WAITING.jpg
