DucTrung1802/ROS-2-Reports/Images/Pure PID controller flowchart.png

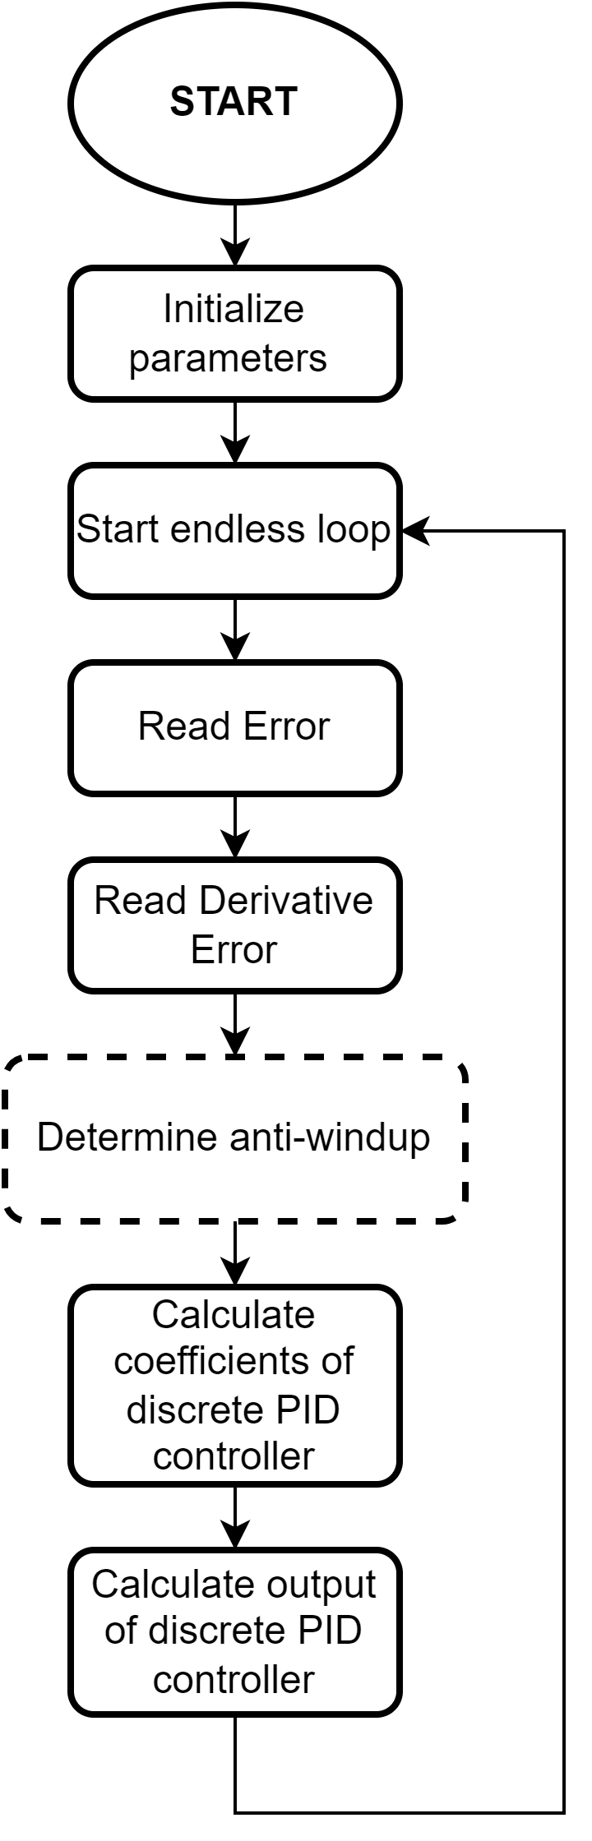
Images/Pure PID controller flowchart.png
