DucTrung1802/ROS-2-Reports/Images/Raspberry Pi 4 Firmware - class Oled.png

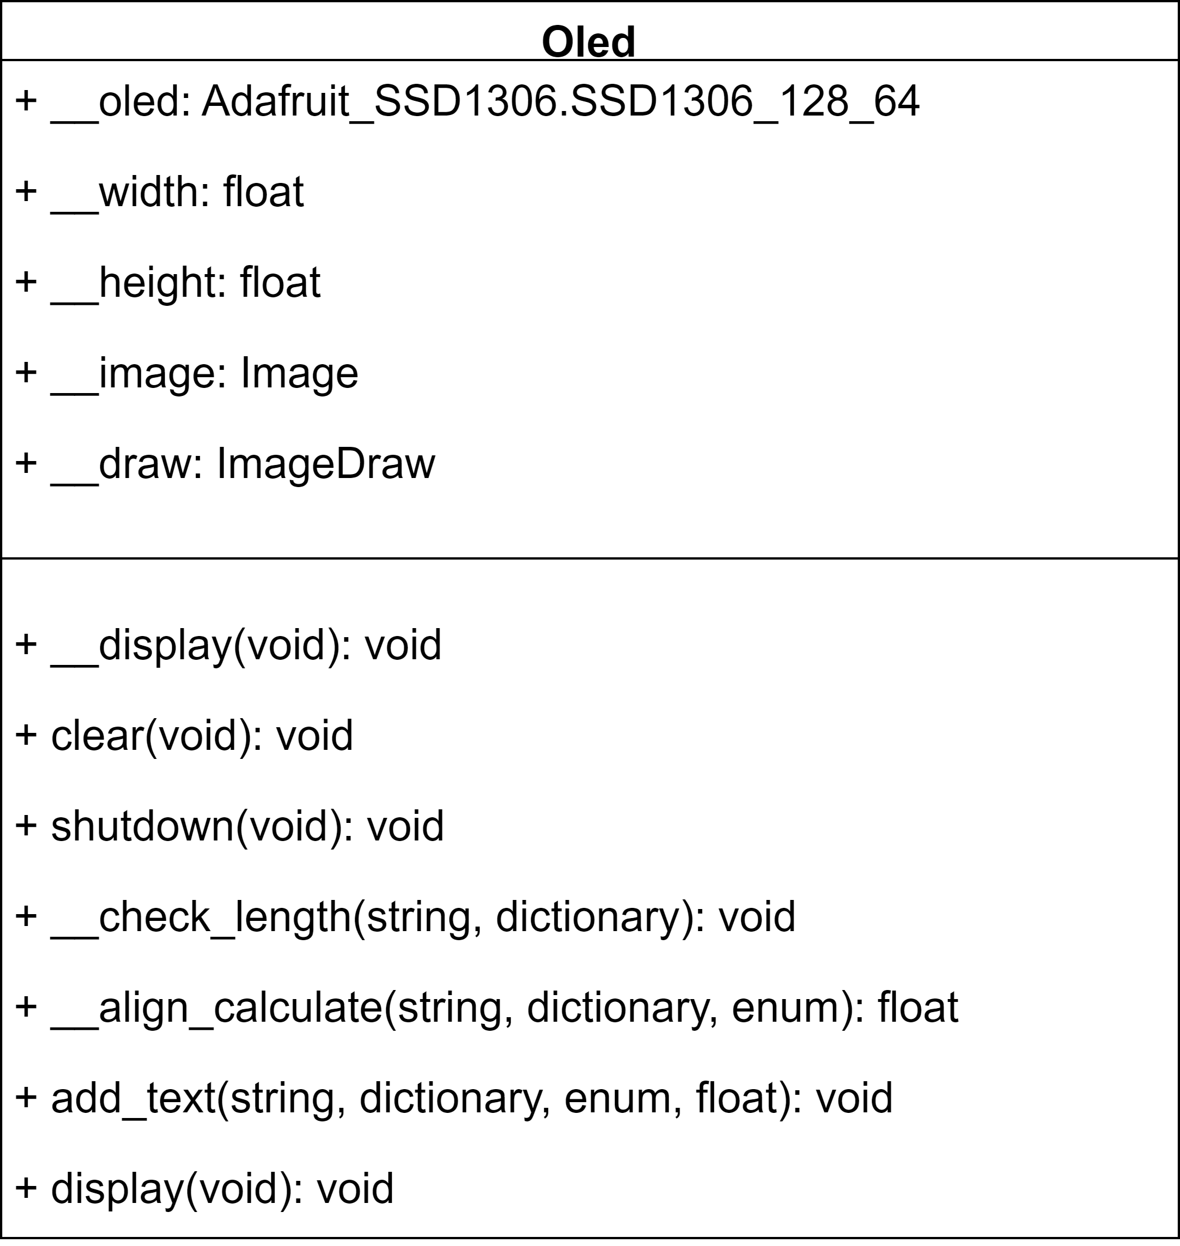
Images/Raspberry Pi 4 Firmware - class Oled.png
