DucTrung1802/ROS-2-Reports/Images/Raspberry Pi 4 Firmware - class Sonar.png

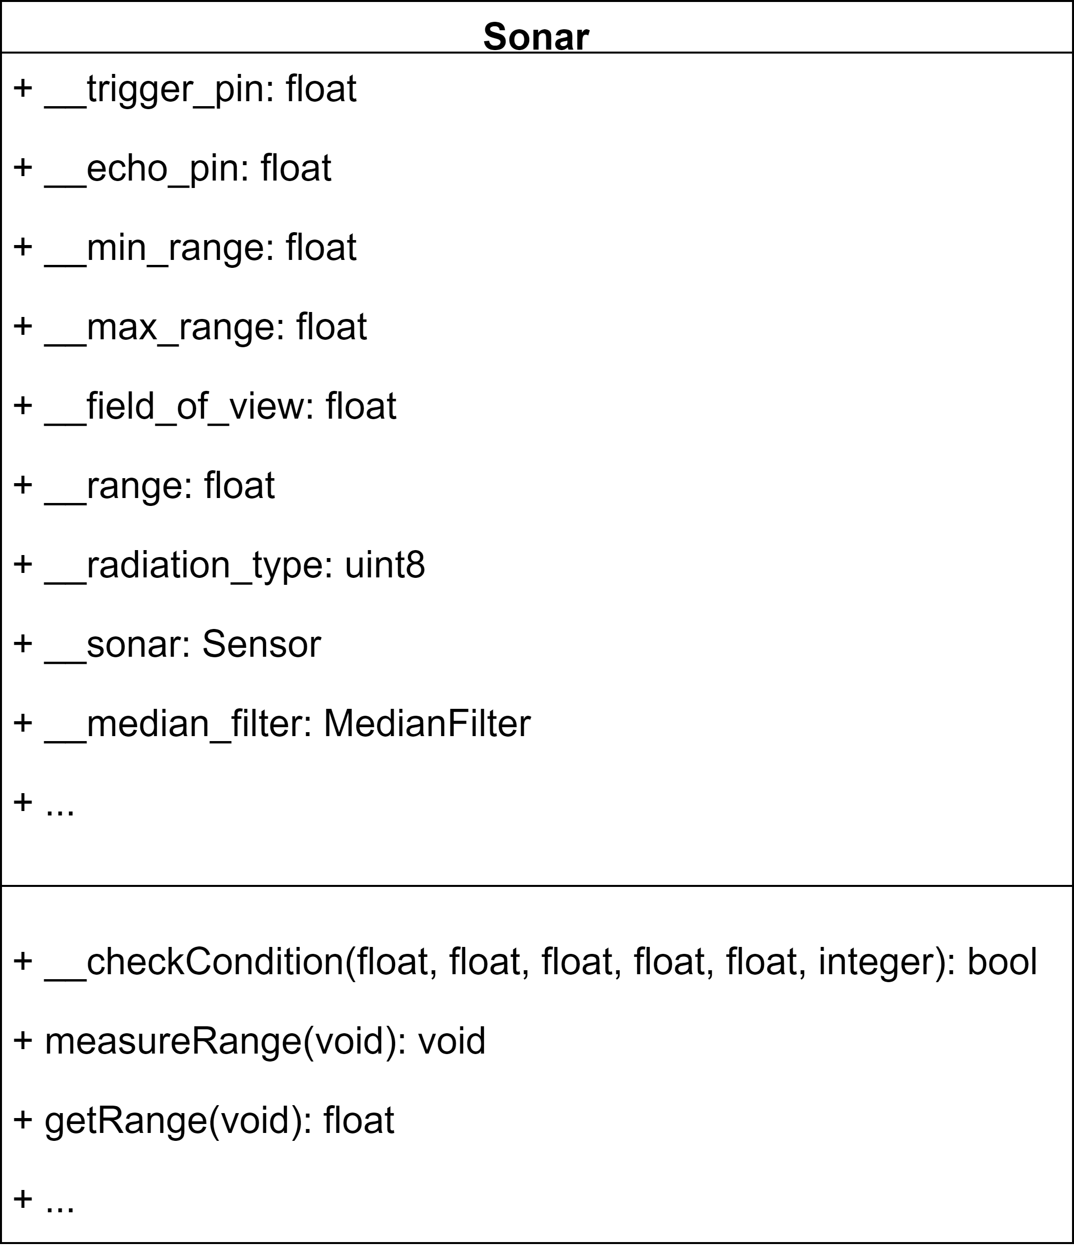
Images/Raspberry Pi 4 Firmware - class Sonar.png
