DucTrung1802/ROS-2-Reports/Images/Restaurant Map.png

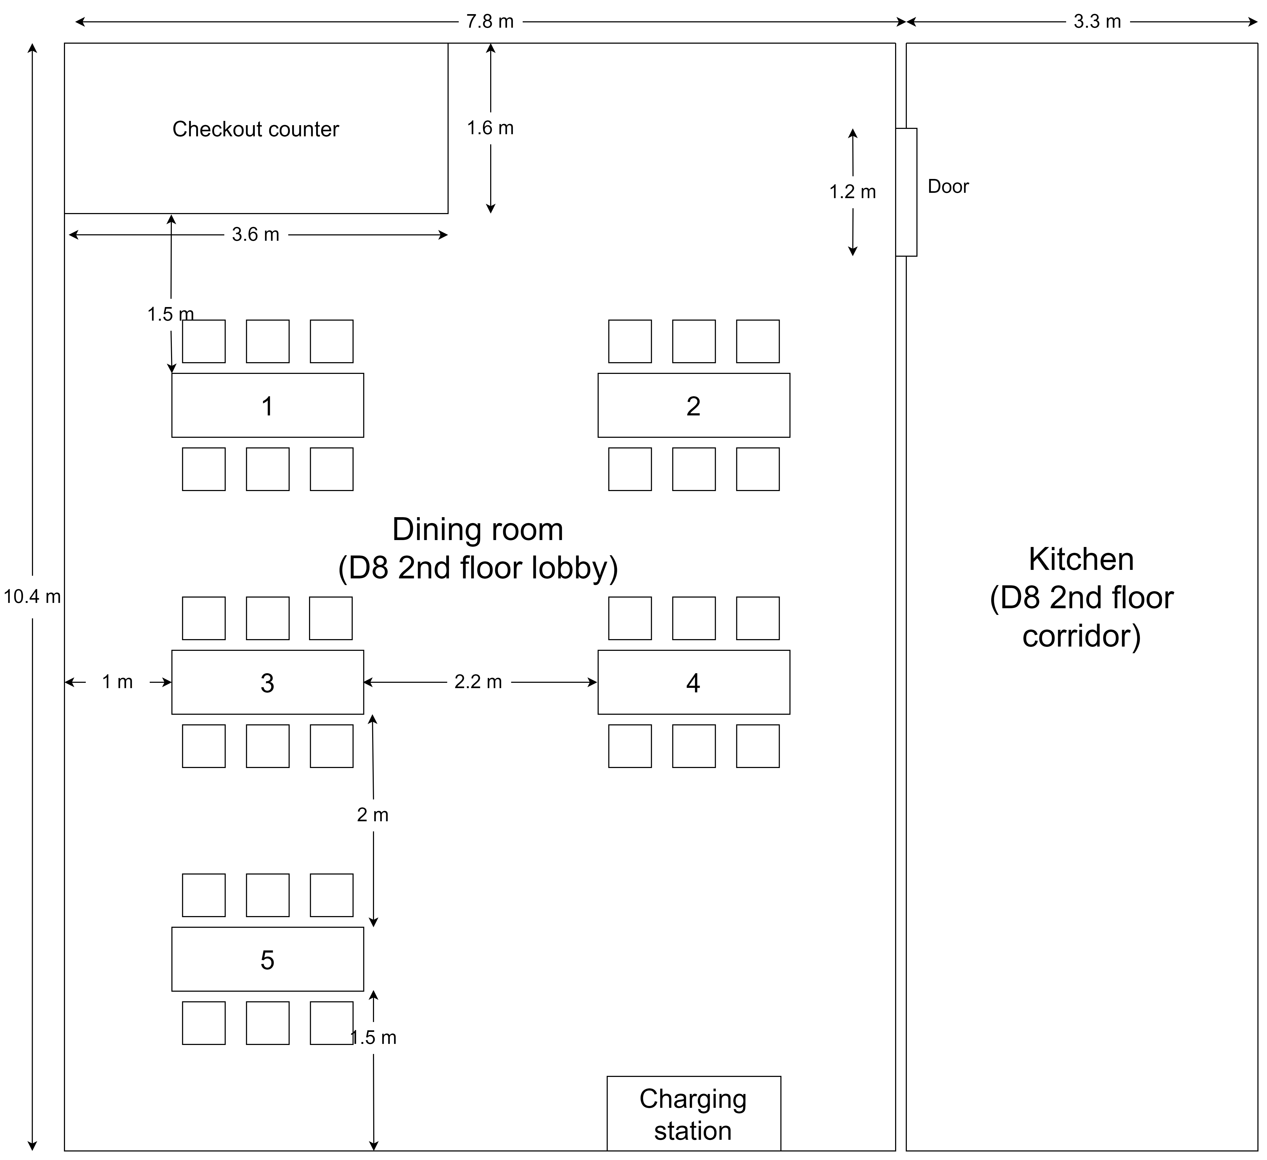
Images/Restaurant Map.png
