DucTrung1802/ROS-2-Reports/Images/ros2.cpp flowchart.png

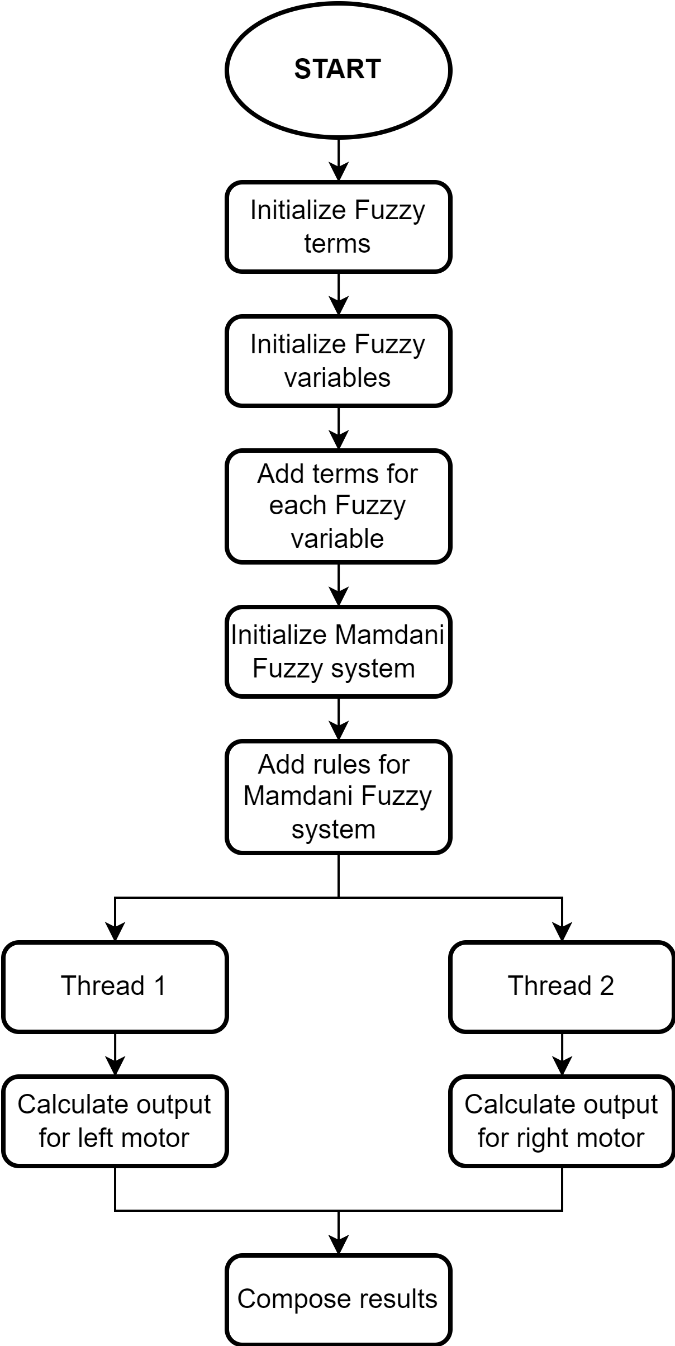
Images/ros2.cpp flowchart.png
