DucTrung1802/ROS-2-Reports/Images/ROS 2 Graph.gif

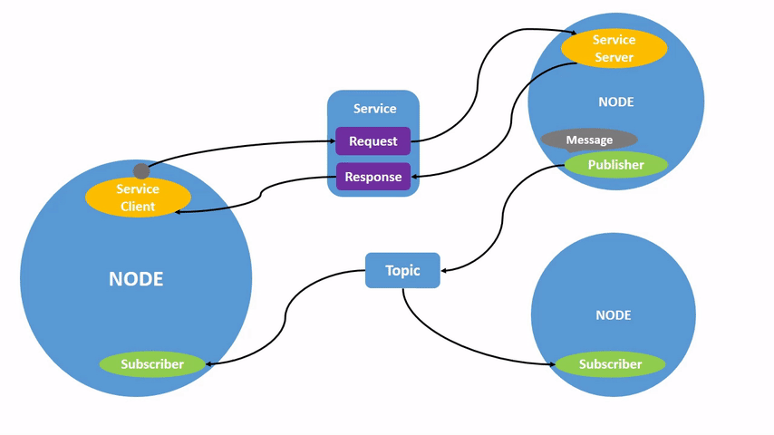
Images/ROS 2 Graph.gif
