DucTrung1802/ROS-2-Reports/Images/Rule Handler class.png

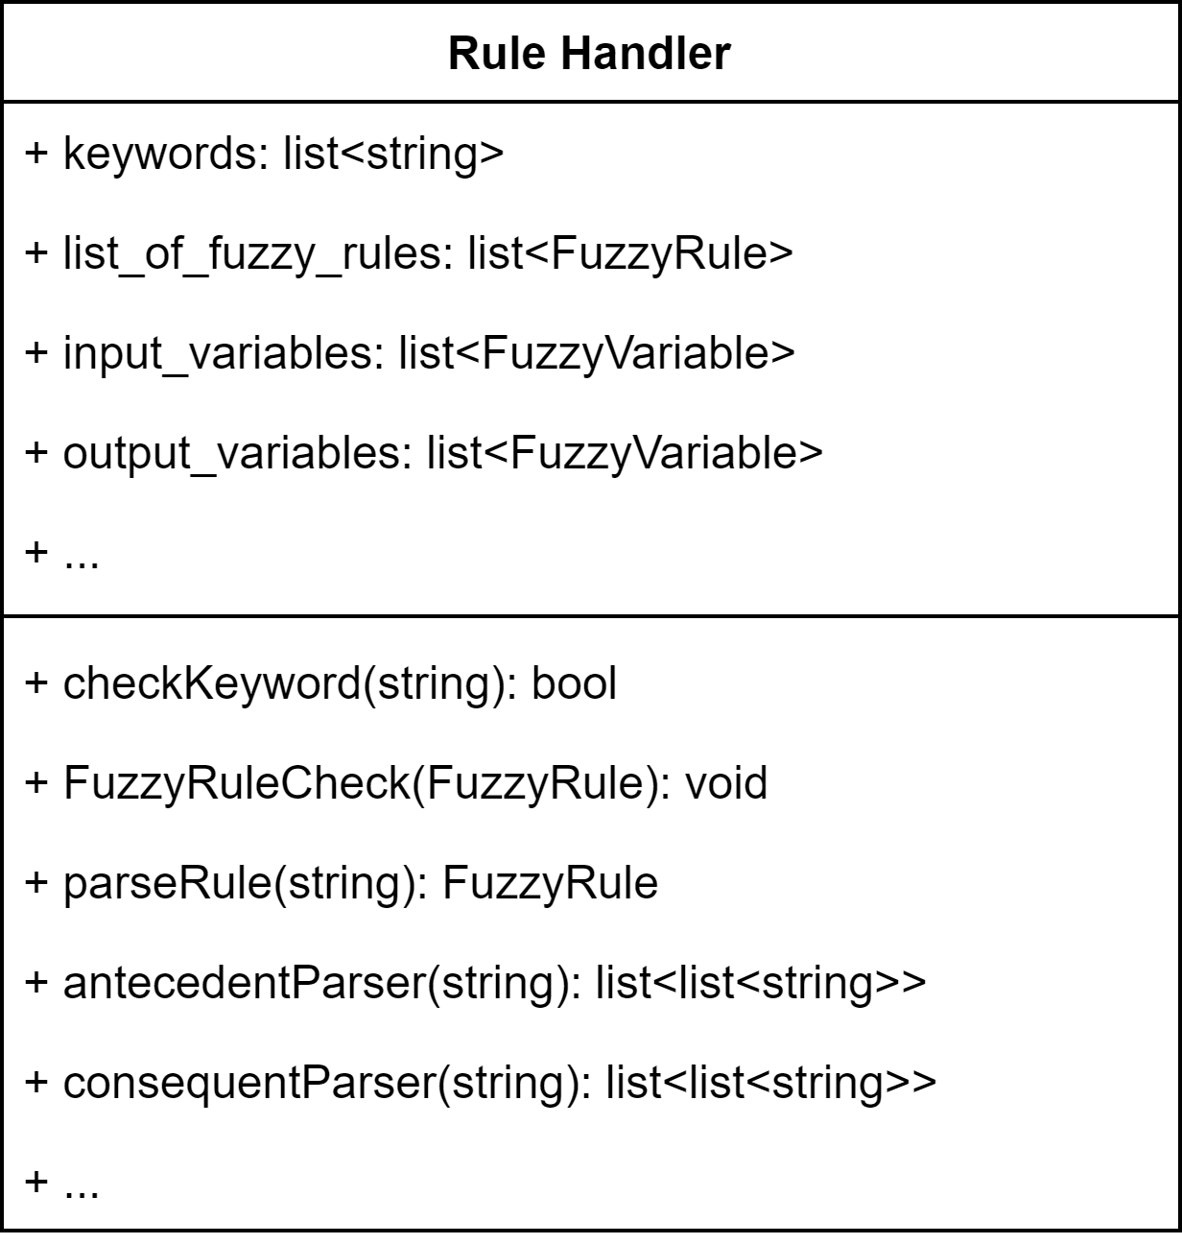
Images/Rule Handler class.png
