DucTrung1802/ROS-2-Reports/Images/Rule Handler data flow.png

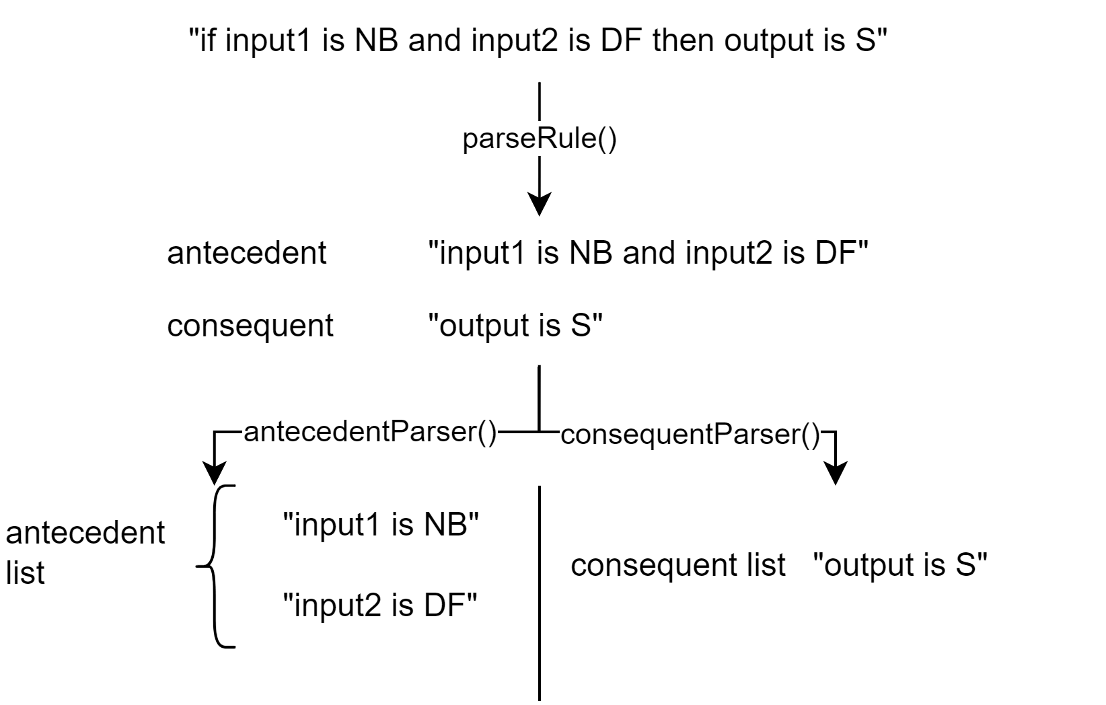
Images/Rule Handler data flow.png
