DucTrung1802/ROS-2-Reports/Images/Running Navigation on Gazebo (left - Gazebo, right - RViz).png

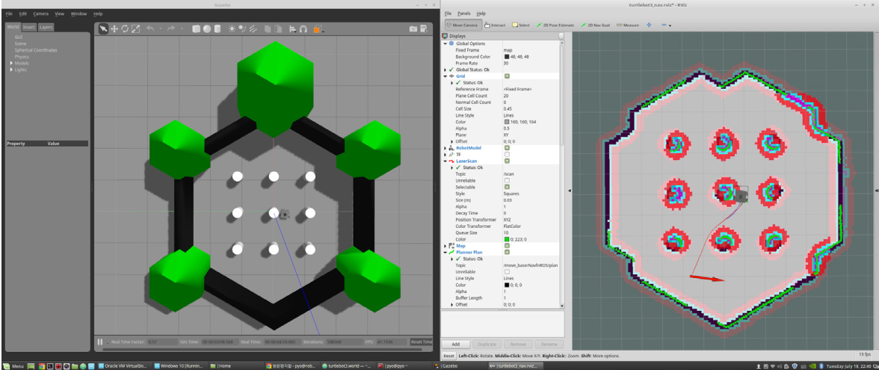
Images/Running Navigation on Gazebo (left - Gazebo, right - RViz).png
