DucTrung1802/ROS-2-Reports/Images/RViz Displays Table 2.png

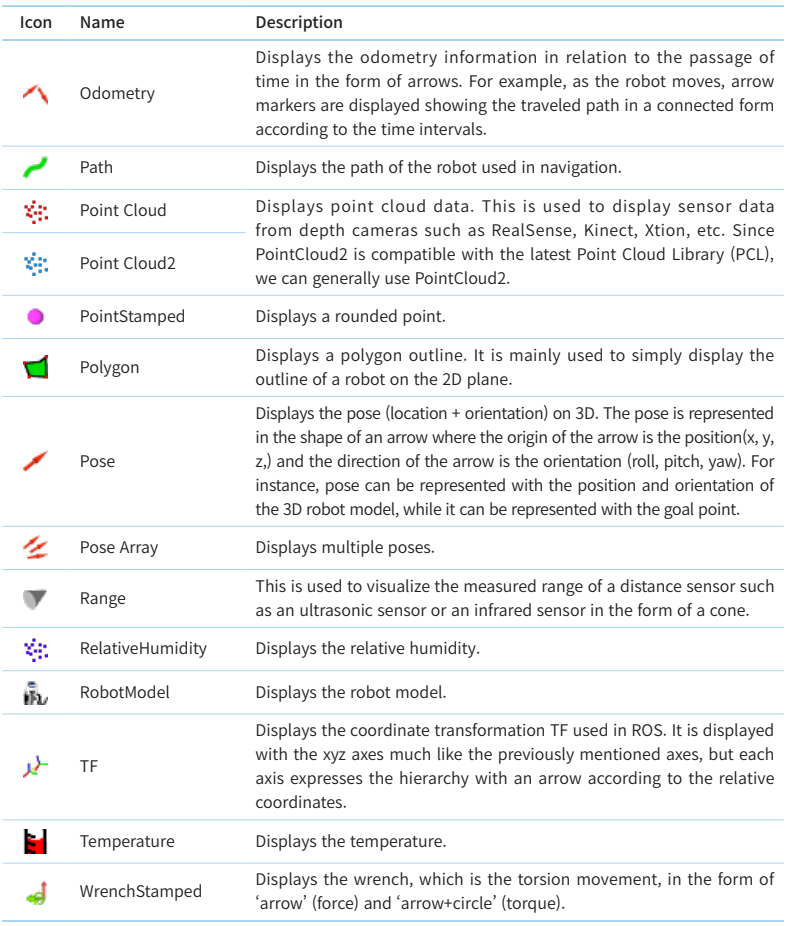
Images/RViz Displays Table 2.png
