DucTrung1802/ROS-2-Reports/Images/ServeBot Firmware Architecture.png

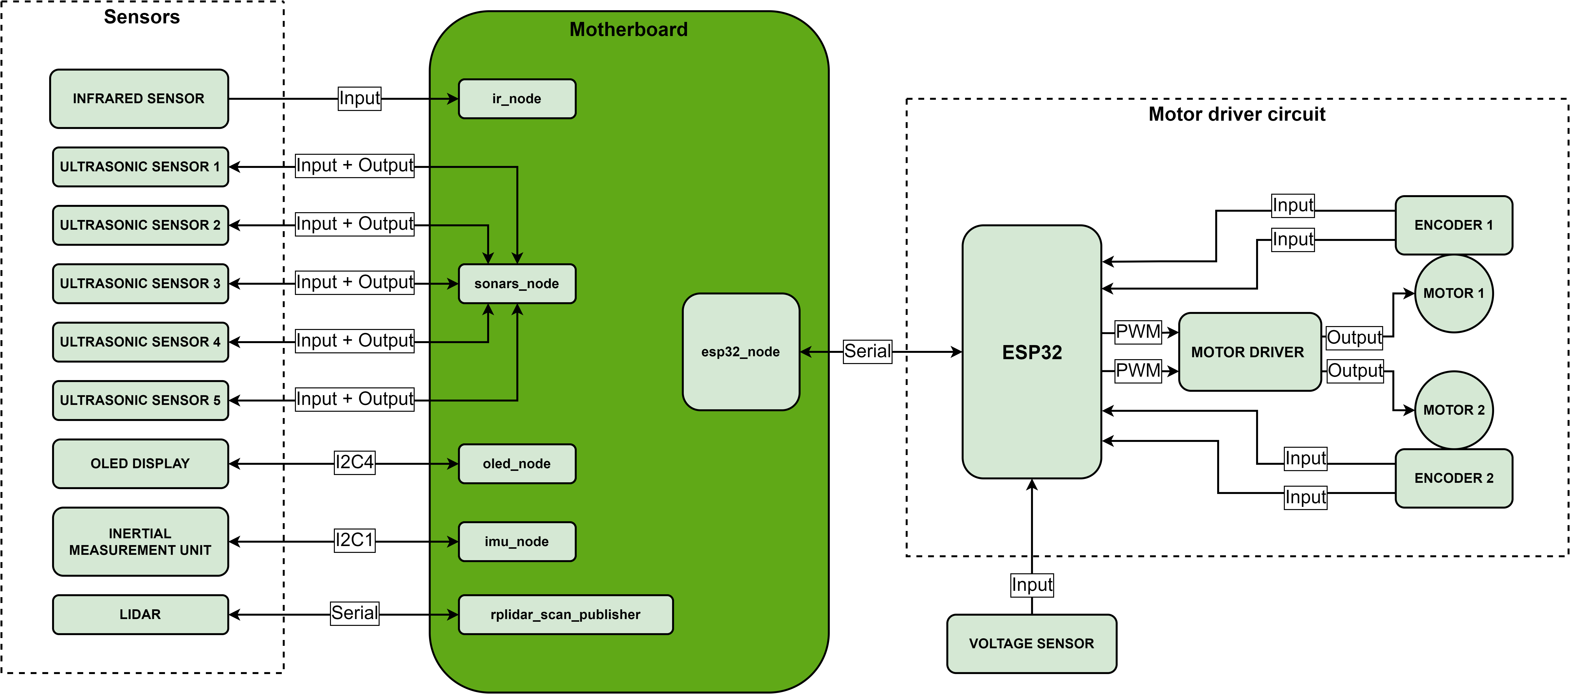
Images/ServeBot Firmware Architecture.png
