DucTrung1802/ROS-2-Reports/Images/Shape of defuzzification.png

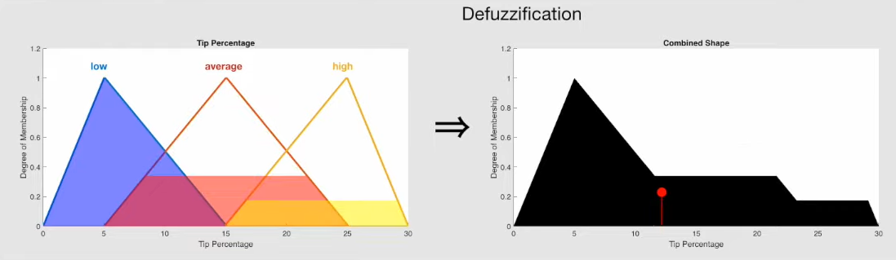
Images/Shape of defuzzification.png
