DucTrung1802/ROS-2-Reports/Images/Term class.png

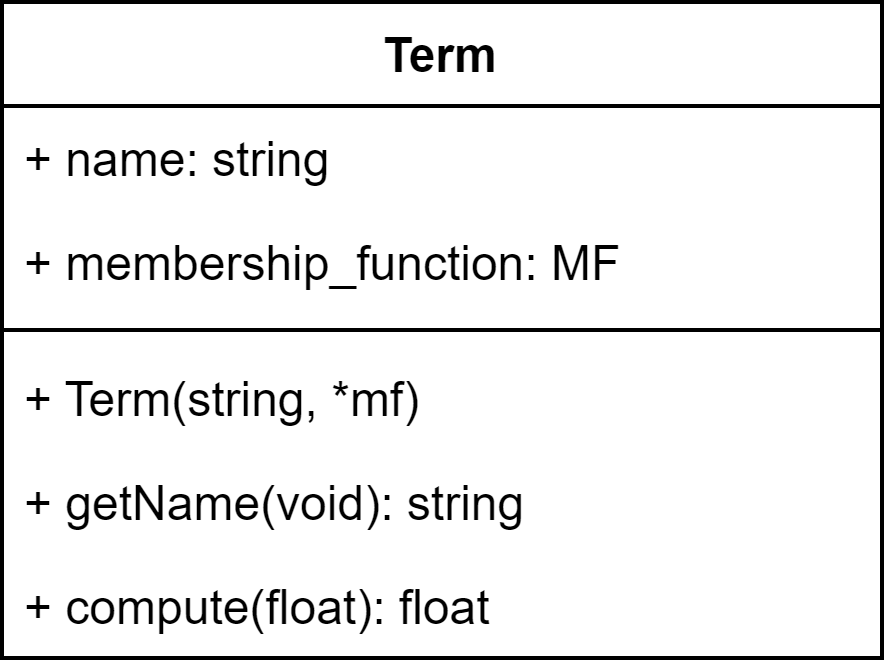
Images/Term class.png
