DucTrung1802/ROS-2-Reports/Images/TurtleBot3 and Environment Model.png

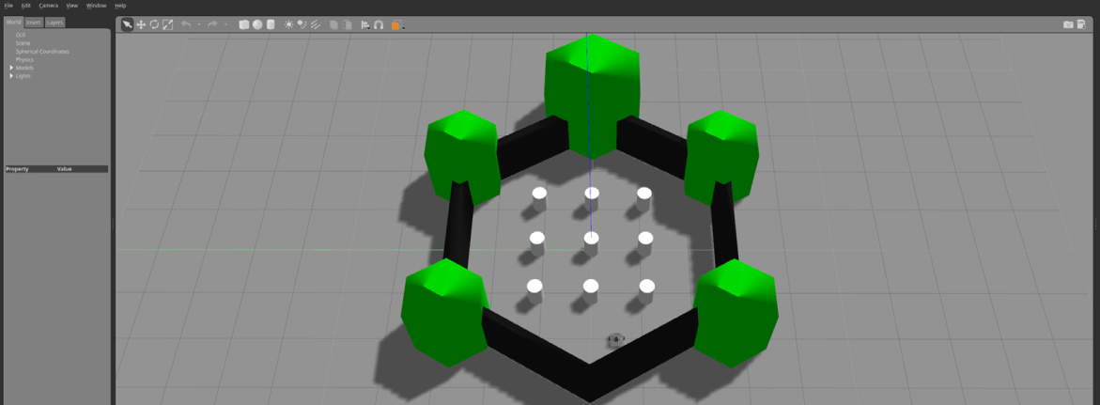
Images/TurtleBot3 and Environment Model.png
