DucTrung1802/ROS-2-Reports/Images/TurtleBot3 automatically moving and avoiding obstacles on Gazebo.png

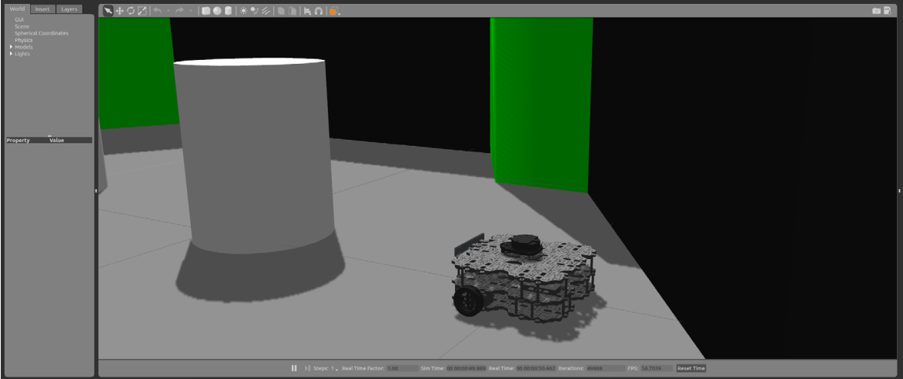
Images/TurtleBot3 automatically moving and avoiding obstacles on Gazebo.png
