DucTrung1802/ROS-2-Reports/Images/Ultrasonic sensor block.png

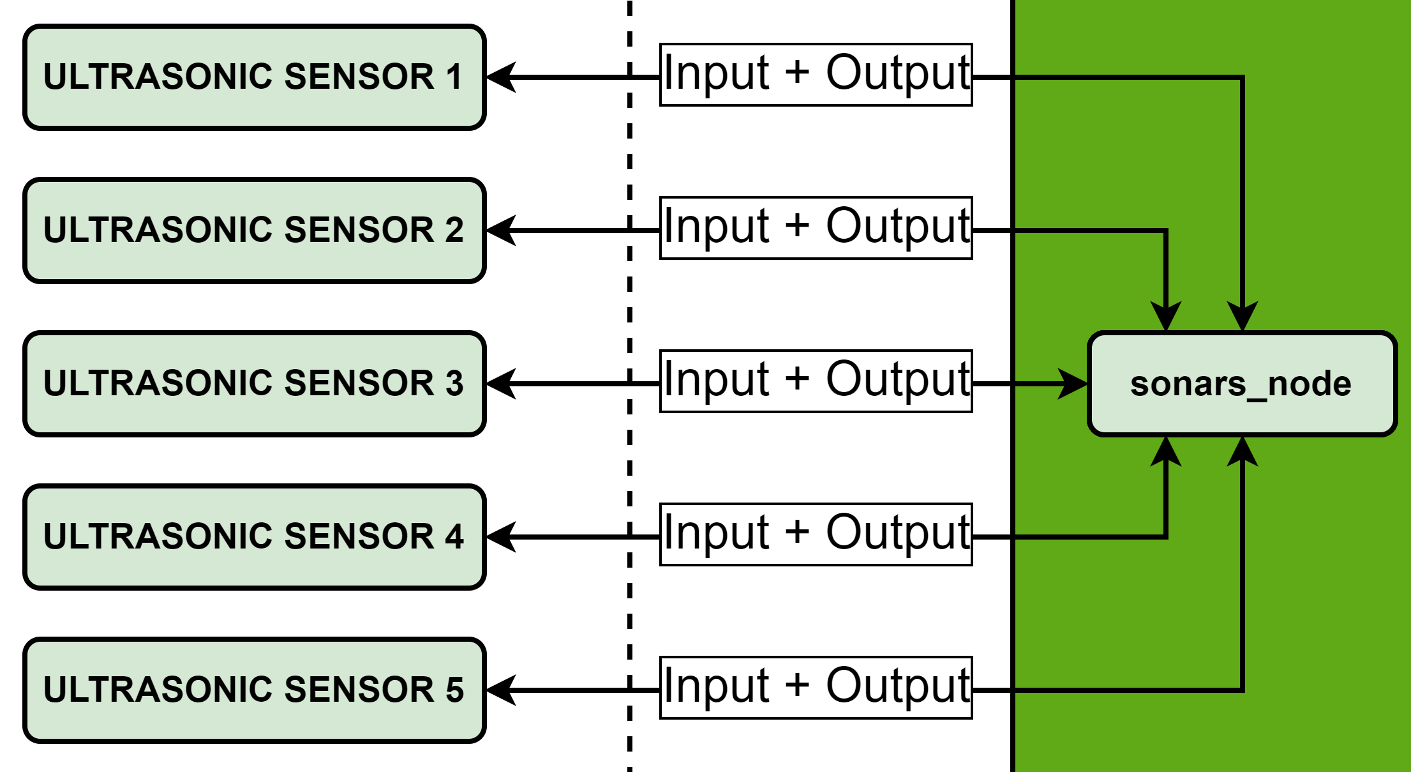
Images/Ultrasonic sensor block.png
