DucTrung1802/ROS-2-Reports/Images/Voltage sensor block.png

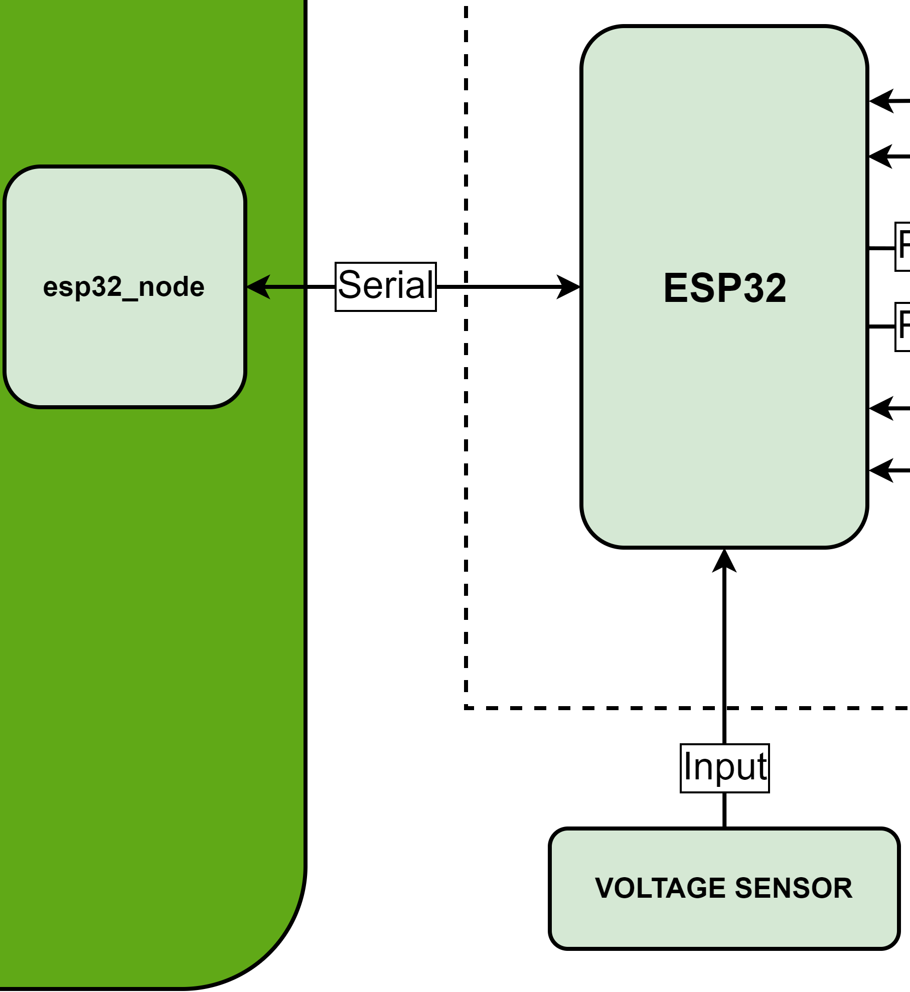
Images/Voltage sensor block.png
