DucTrung1802/ROS-2-Reports/Restaurant Map 2.jpg

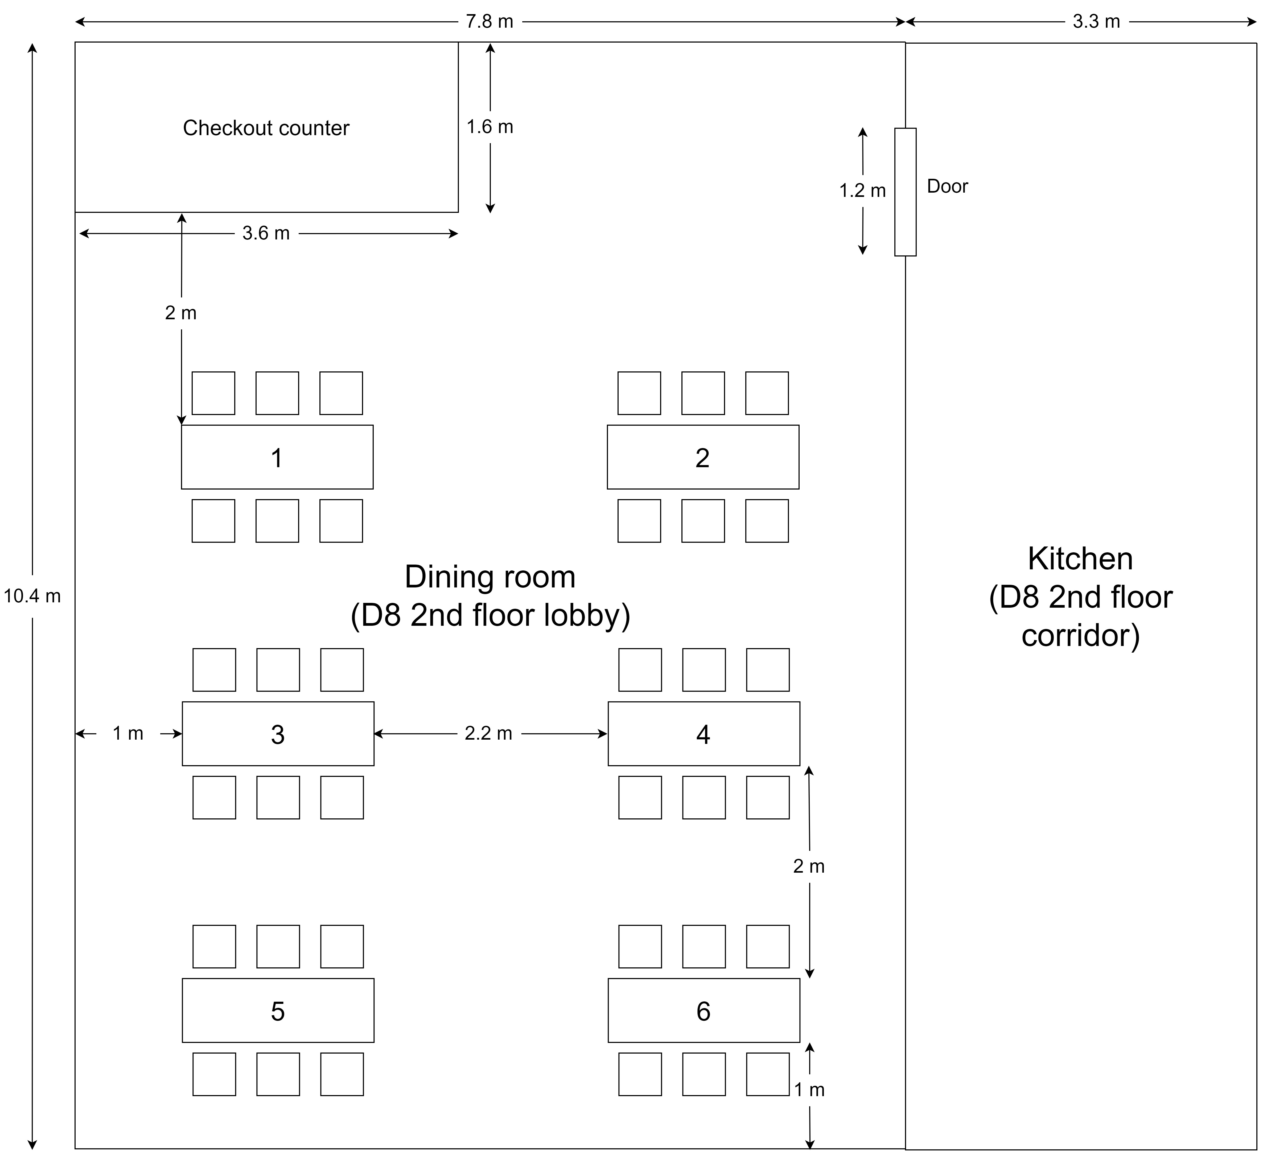
Restaurant Map 2.jpg
