DucTrung1802/ROS-2-Reports/Images/Maximum value of the membership function for each step.png

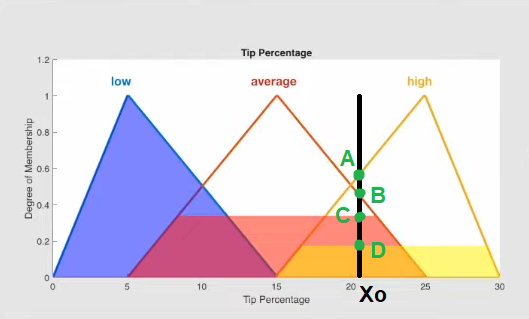
Images/Maximum value of the membership function for each step.png
