DucTrung1802/ROS-2-Reports/Images/Memory usage of RECEIVING DATA.png

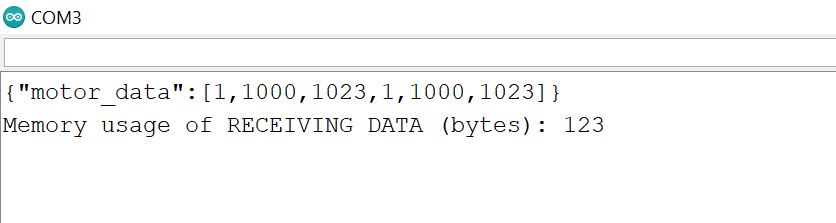
Images/Memory usage of RECEIVING DATA.png
