DucTrung1802/ROS-2-Reports/Images/Memory usage of SENDING DATA.png

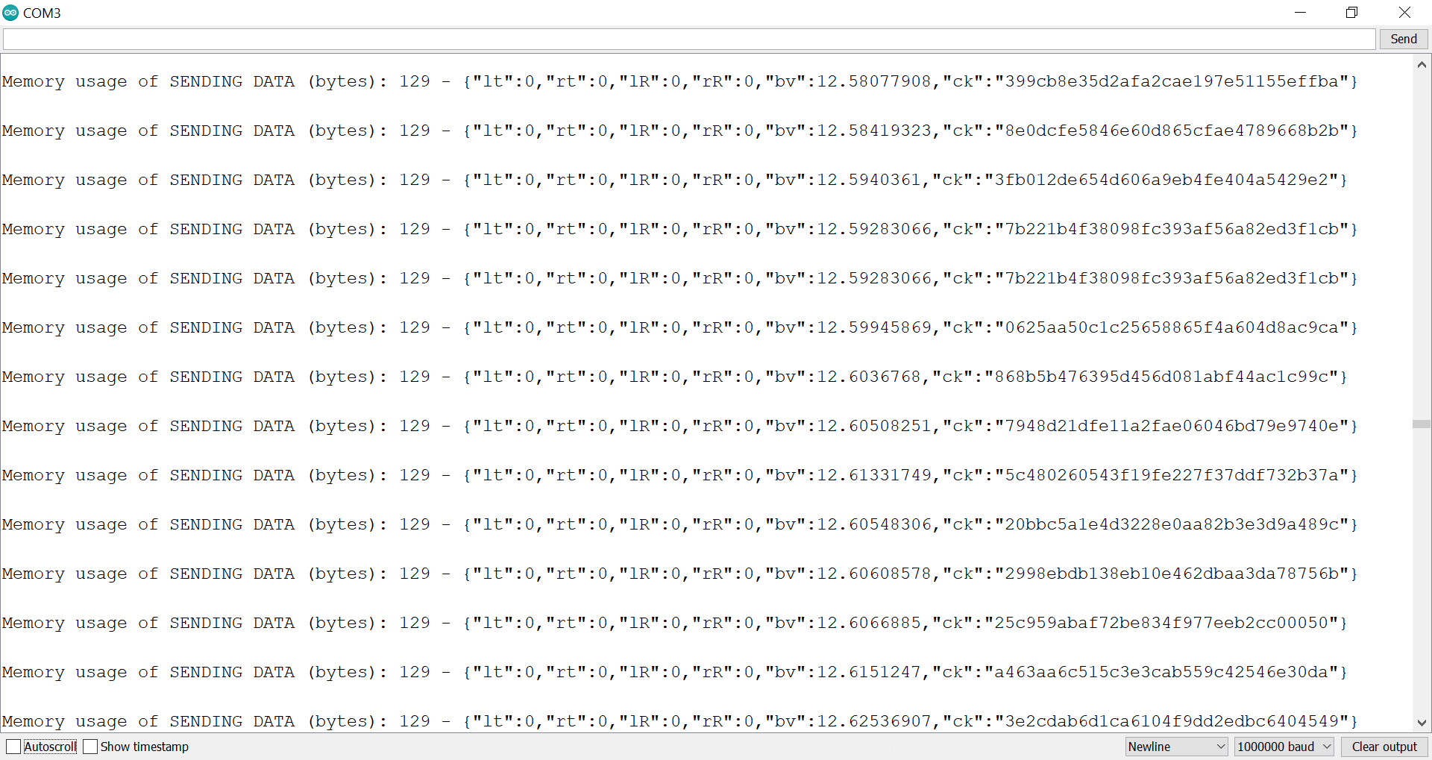
Images/Memory usage of SENDING DATA.png
