DucTrung1802/ROS-2-Reports/Images/Inertial measurement unit sensor block.png

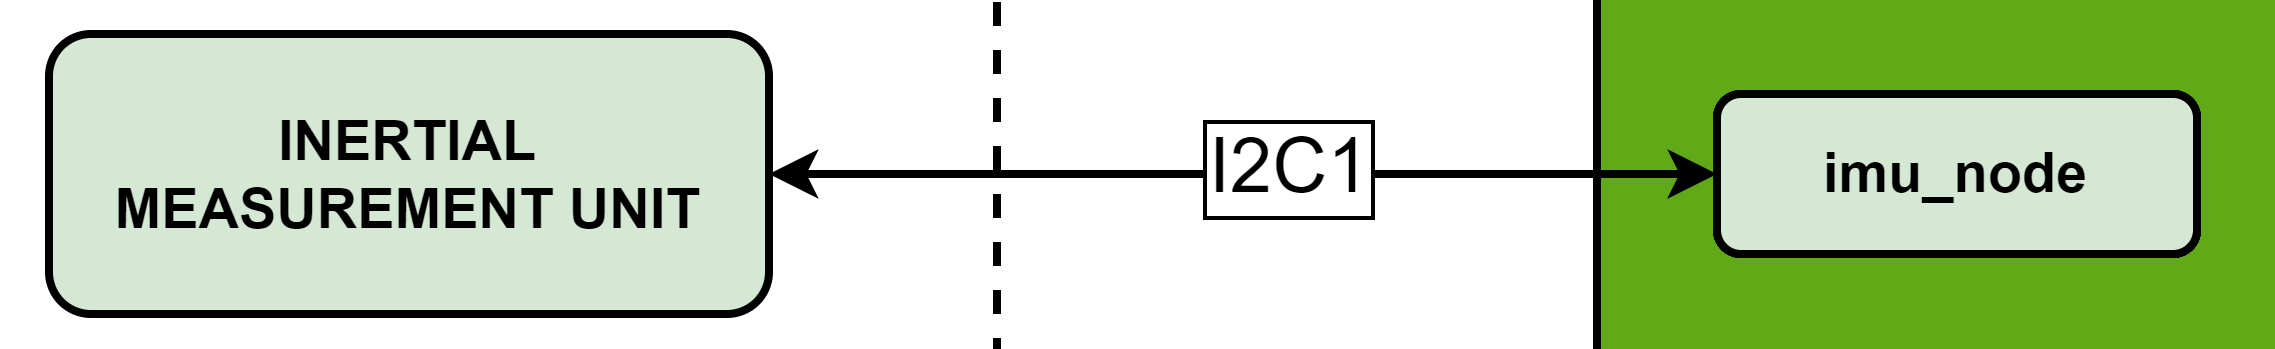
Images/Inertial measurement unit sensor block.png
