DucTrung1802/ROS-2-Reports/(commit log)

2022-07-17 #2 bìa - complete 90% - thiếu chuyên ngành bằng TA
2022-07-20 #15 working on part 2.7.1 EPS32 firmware, part Sending data to Raspberry Pi 4
2022-07-20 #16 working on part 2.7.1, part Counting pulses of encoders and calculating RPM of motors
2022-07-21 #18 update mục lục
2022-07-21 #19 BIG UPDATE: update mục lục
2022-07-21 #20 BIG UPDATE: update mục lục cho Thesis
2022-07-21 #21 add báo cáo Đồ Án 2
2022-07-21 #22 working on part Packaging data for sending to Raspberry Pi 4
    4.3.2 Firmware for ESP32 microcontroller, part Packaging data for sending to Raspberry Pi 4
2022-07-21 #23 working on part Choosing baud rate for serial port
    4.3.2 Firmware for ESP32 microcontroller, part choosing baud rate
2022-07-21 #24 add esp32 firmware
2022-07-22 #25 working with part 4.3.3 Firmware for Raspberry Pi 4
2022-07-22 #26 BIG UPDATE: update mục lục, working on part 4.3.3 Firmware for Raspberry Pi 4
2022-07-23 #27 part 4.3.3 Firmware for Raspberry Pi 4 - draft 1
2022-07-23 #28 part 4.4 Firmware for ultrasonic sensors - draft 1
2022-07-23 #29 part 4.4 Firmware for ultrasonic sensors - draft 2
2022-07-24 #30 part 4.5 Firmware for lidar - draft 1
2022-07-25 #34 part 4.8 Firmware for infrared sensor - draft 1
2022-07-25 #35 part 3.2 The basis for selecting ROS - working
    change the position of part battery voltage block after motor driver block
2022-07-25 #38 BIG UPDATE: add all current image files
2022-07-27 #49 part 5.1.6 Tuning a PID controller - working
2022-07-28 #55 check LƯU Ý ở dưới figure 18
2022-07-28 #57 part 5.3.1 C++ Fuzzy Logic Library - working
    f) “Fuzzy Variable” class
2022-07-28 #58 part 5.3.1 C++ Fuzzy Logic Library - working
    g) Mamdani Fuzzy System” class
2022-07-29 #59 part 5.3.1 C++ Fuzzy Logic Library - working
    g) “Mamdani Fuzzy System” class
    • AND operator
2022-07-30 #61 5.3.2 Fuzzy logic file for PID controller (ros2.cpp) - working
2022-07-30 #66 part PID controller programming - working
    alpha, beta, gamma calculation
2022-07-31 #67 part PID controller programming - draft 1
2022-08-04 #72 add battery status file
2022-08-05 #73 update battery status file
2022-08-05 #74 update battery status file
2022-08-05 #75 BIG UPDATE battery status file
